jernejsk/sbc-uart-hub/docs/img/render-top.png

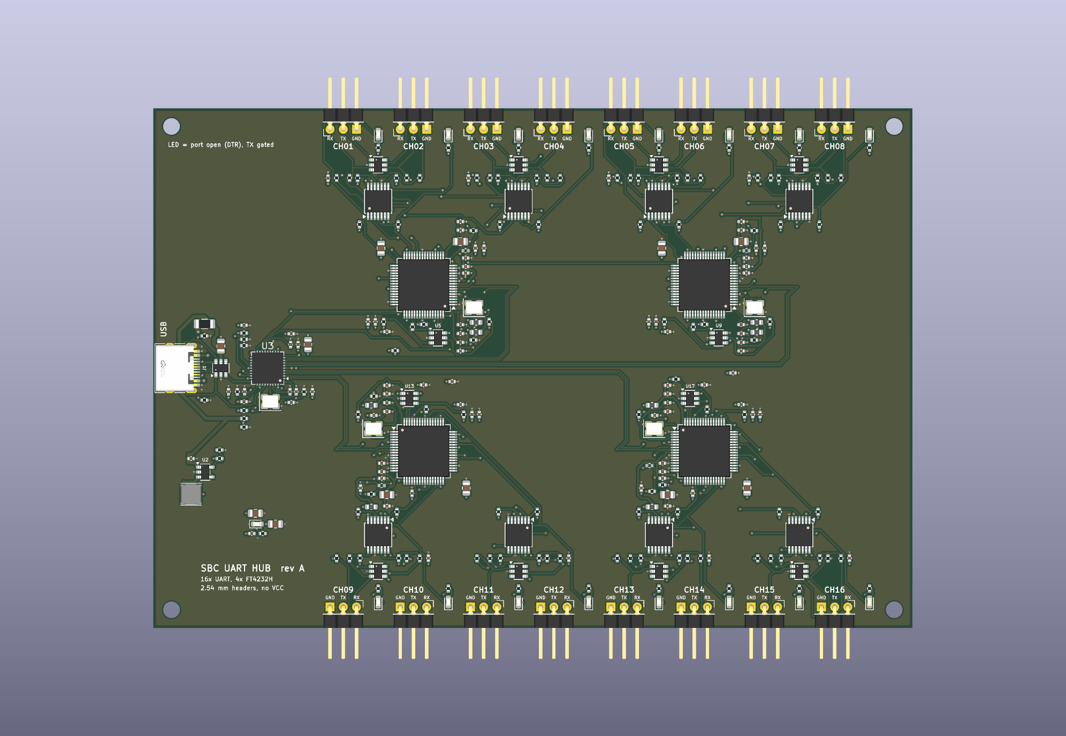
docs/img/render-top.png
