jernejsk/sbc-uart-hub/docs/img/render-iso.png

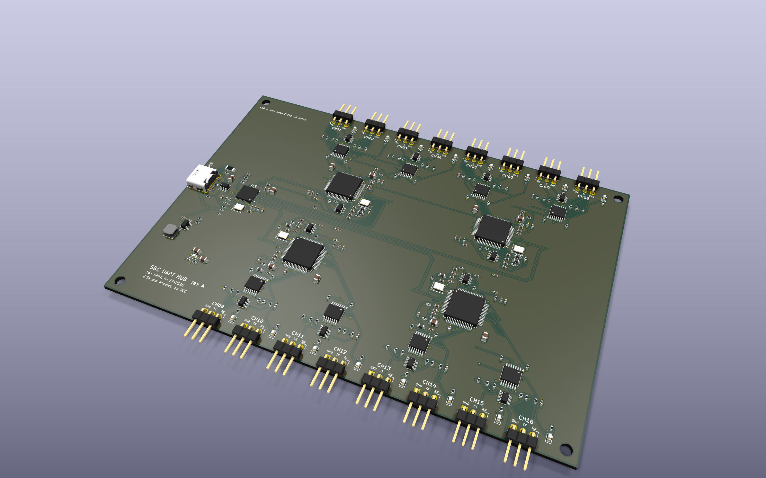
docs/img/render-iso.png
