jernejsk/sbc-uart-hub/docs/img/render-bottom.png

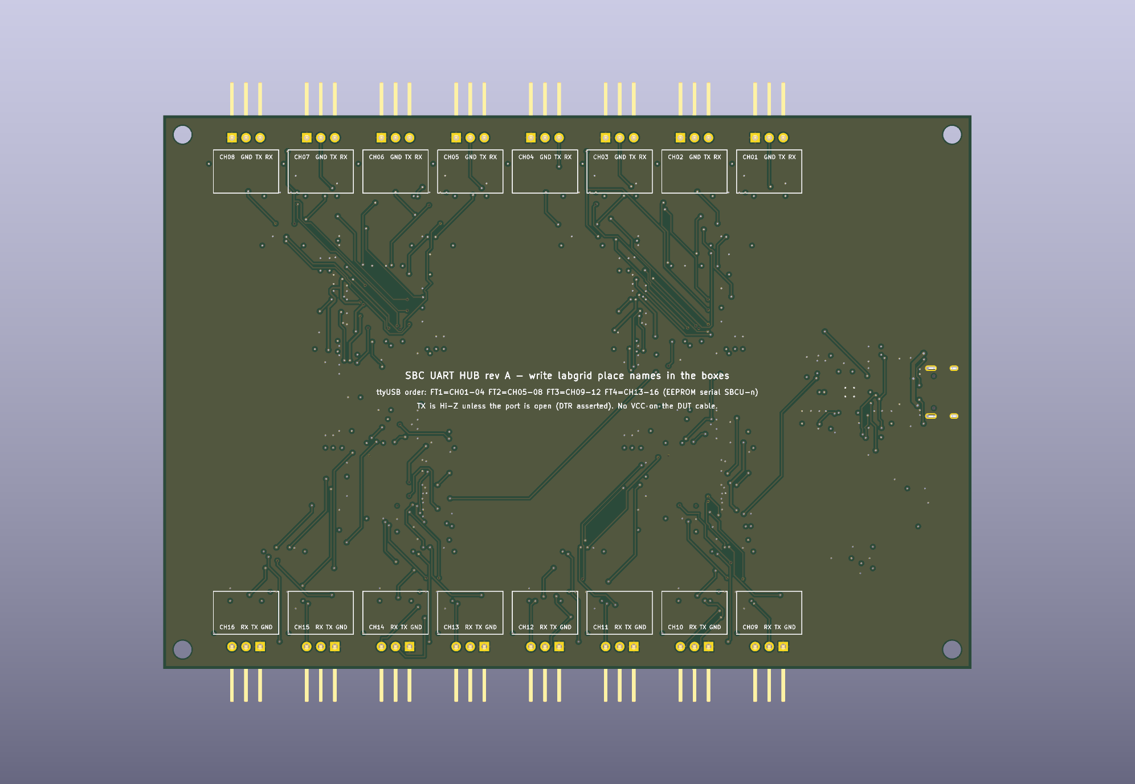
docs/img/render-bottom.png
