jernejsk/sbc-uart-hub/fab/render-bottom.png

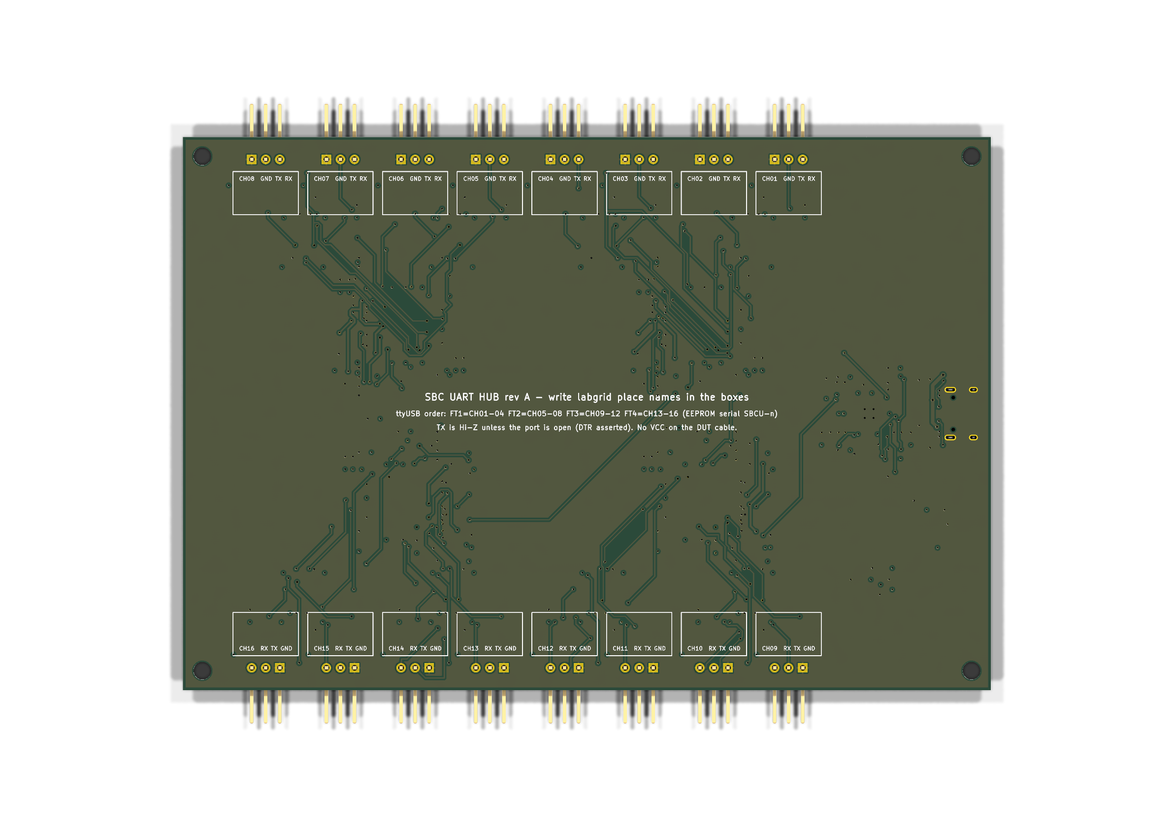
fab/render-bottom.png
