jernejsk/sbc-uart-hub/fab/render-top.png

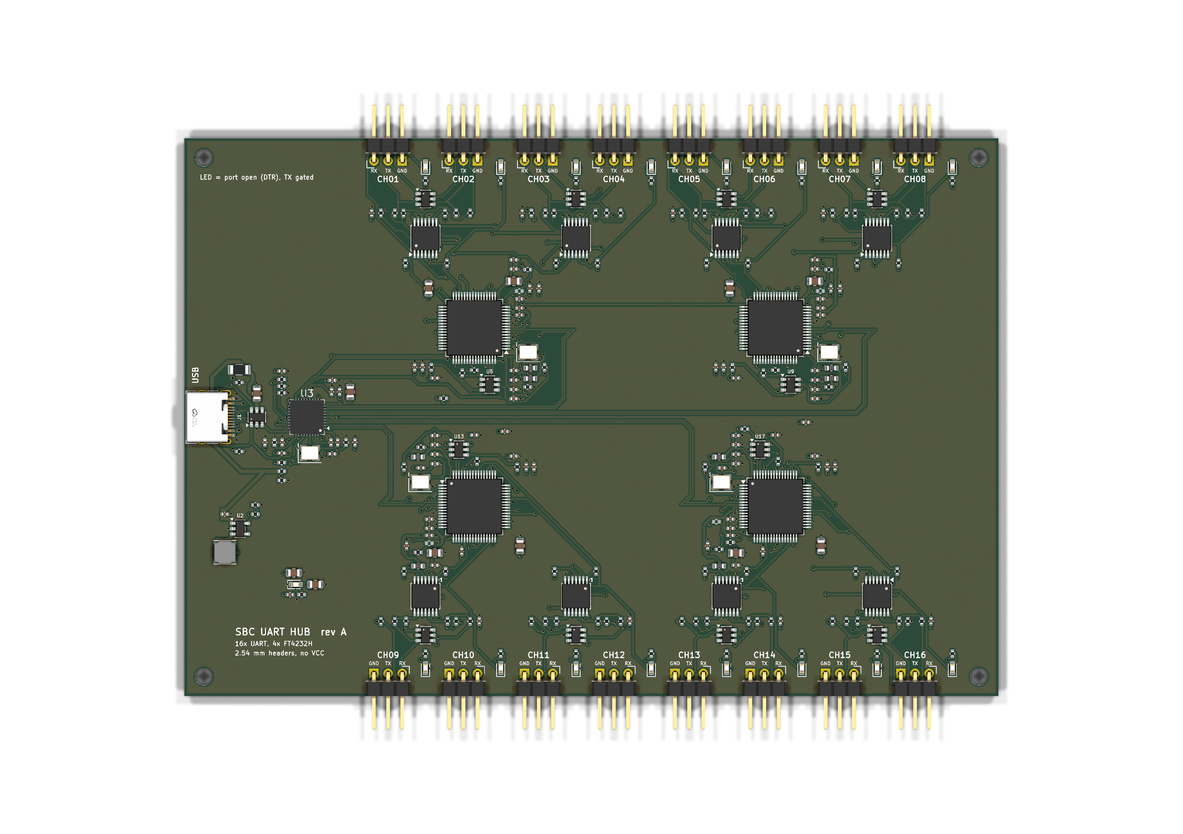
fab/render-top.png
