jernejsk/sbc-uart-hub/fab/bom_jlc.csv

Comment | Designator | Footprint | LCSC Part # | Qty
10u | C1,C3,C4 | C_0805_2012Metric | C15850 | 3
100n | C2,C5,C6,C7,C8,C9,C10,C11,C13,C14,C18,C22,C24,C25,C26,C27,C28,C29,C30,C32,C34,C35,C36,C37,C41,C43,C44,C45,C46,C47,C48,C49,C51,C53,C54,C55,C56,C60,C62,C63,C64,C65,C66,C67,C68,C70,C72,C73,C74,C75,C79,C81,C82,C83,C84,C85,C86,C87,C89,C91,C92,C93 | C_0402_1005Metric | C1525 | 62
4u7 | C12,C21,C23,C40,C42,C59,C61,C78,C80 | C_0805_2012Metric | C1779 | 9
33p | C15,C16 | C_0402_1005Metric | C1562 | 2
1u | C17,C31,C33,C50,C52,C69,C71,C88,C90 | C_0402_1005Metric | C52923 | 9
27p | C19,C20,C38,C39,C57,C58,C76,C77 | C_0402_1005Metric | C1557 | 8
red | D1 | LED_0603_1608Metric | C2286 | 1
ESDA6V1-5SC6 | D2,D5,D8,D11,D14,D17,D20,D23 | SOT-23-6 | C2827672 | 8
green | D3,D4,D6,D7,D9,D10,D12,D13,D15,D16,D18,D19,D21,D22,D24,D25 | LED_0603_1608Metric | C12624 | 16
1.1A | F1 | Fuse_1206_3216Metric | C20801 | 1
600R@100MHz | FB1,FB2,FB3,FB4,FB5,FB6,FB7,FB8 | L_0603_1608Metric | C1002 | 8
USB-C | J1 | USB_C_Receptacle_HRO_TYPE-C-31-M-12 | C165948 | 1
Header 1x3 RA | J101,J102,J103,J104,J105,J106,J107,J108,J109,J110,J111,J112,J113,J114,J115,J116 | PinHeader_1x03_P2.54mm_Horizontal_Edge | C492411 | 16
2u2 | L1 | L_Taiyo-Yuden_NR-40xx | C83423 | 1
5k1 | R1,R2 | R_0402_1005Metric | C25905 | 2
100k | R3,R8,R9,R10,R11,R12,R13,R26,R31,R36,R41,R52,R57,R62,R67,R78,R83,R88,R93,R104,R109,R114,R119 | R_0402_1005Metric | C25741 | 23
22k | R4 | R_0402_1005Metric | C25768 | 1
1k | R5,R28,R33,R38,R43,R54,R59,R64,R69,R80,R85,R90,R95,R106,R111,R116,R121 | R_0402_1005Metric | C11702 | 17
12k 1% | R6,R22,R48,R74,R100 | R_0402_1005Metric | C25752 | 5
10k | R7,R18,R19,R20,R23,R27,R32,R37,R42,R44,R45,R46,R49,R53,R58,R63,R68,R70,R71,R72,R75,R79,R84,R89,R94,R96,R97,R98,R101,R105,R110,R115,R120 | R_0402_1005Metric | C25744 | 33
2k2 | R21,R47,R73,R99 | R_0402_1005Metric | C25879 | 4
220R | R24,R25,R29,R30,R34,R35,R39,R40,R50,R51,R55,R56,R60,R61,R65,R66,R76,R77,R81,R82,R86,R87,R91,R92,R102,R103,R107,R108,R112,R113,R117,R118 | R_0402_1005Metric | C25091 | 32
USBLC6-2SC6 | U1 | SOT-23-6 | C7519 | 1
TLV62569DBV | U2 | SOT-23-5 | C141836 | 1
USB2514B | U3 | QFN-36-1EP_6x6mm_P0.5mm_EP3.7x3.7mm | C16251 | 1
FT4232HL | U4,U8,U12,U16 | LQFP-64_10x10mm_P0.5mm | C56742 | 4
93LC56B | U5,U9,U13,U17 | SOT-23-6 | C190271 | 4
74LVC125APW | U6,U7,U10,U11,U14,U15,U18,U19 | TSSOP-14_4.4x5mm_P0.65mm | C6059 | 8
24MHz | Y1 | Crystal_SMD_3225-4Pin_3.2x2.5mm | C15643 | 1
12MHz | Y2,Y3,Y4,Y5 | Crystal_SMD_3225-4Pin_3.2x2.5mm | C9002 | 4
