jernejsk/sbc-uart-hub/fab/sbc-uart-hub-schematic.pdf

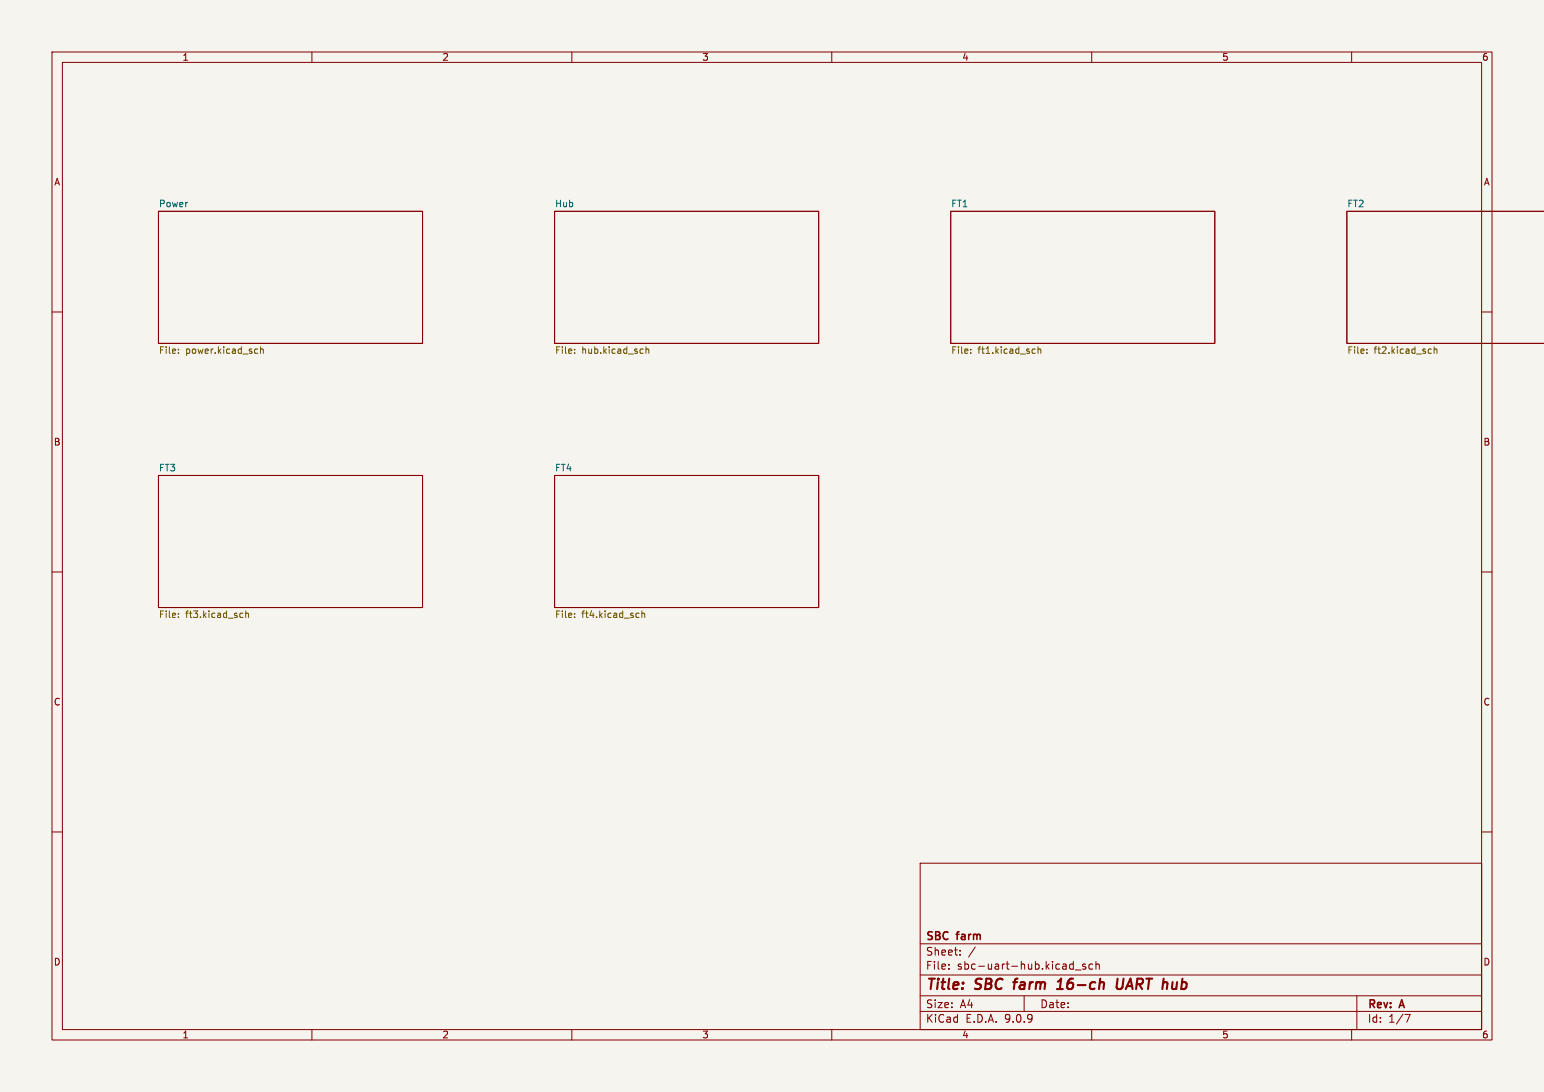
[picture p6: page 1]

File: sbc-uart-hub.kicad_sch Sheet: / SBC farm

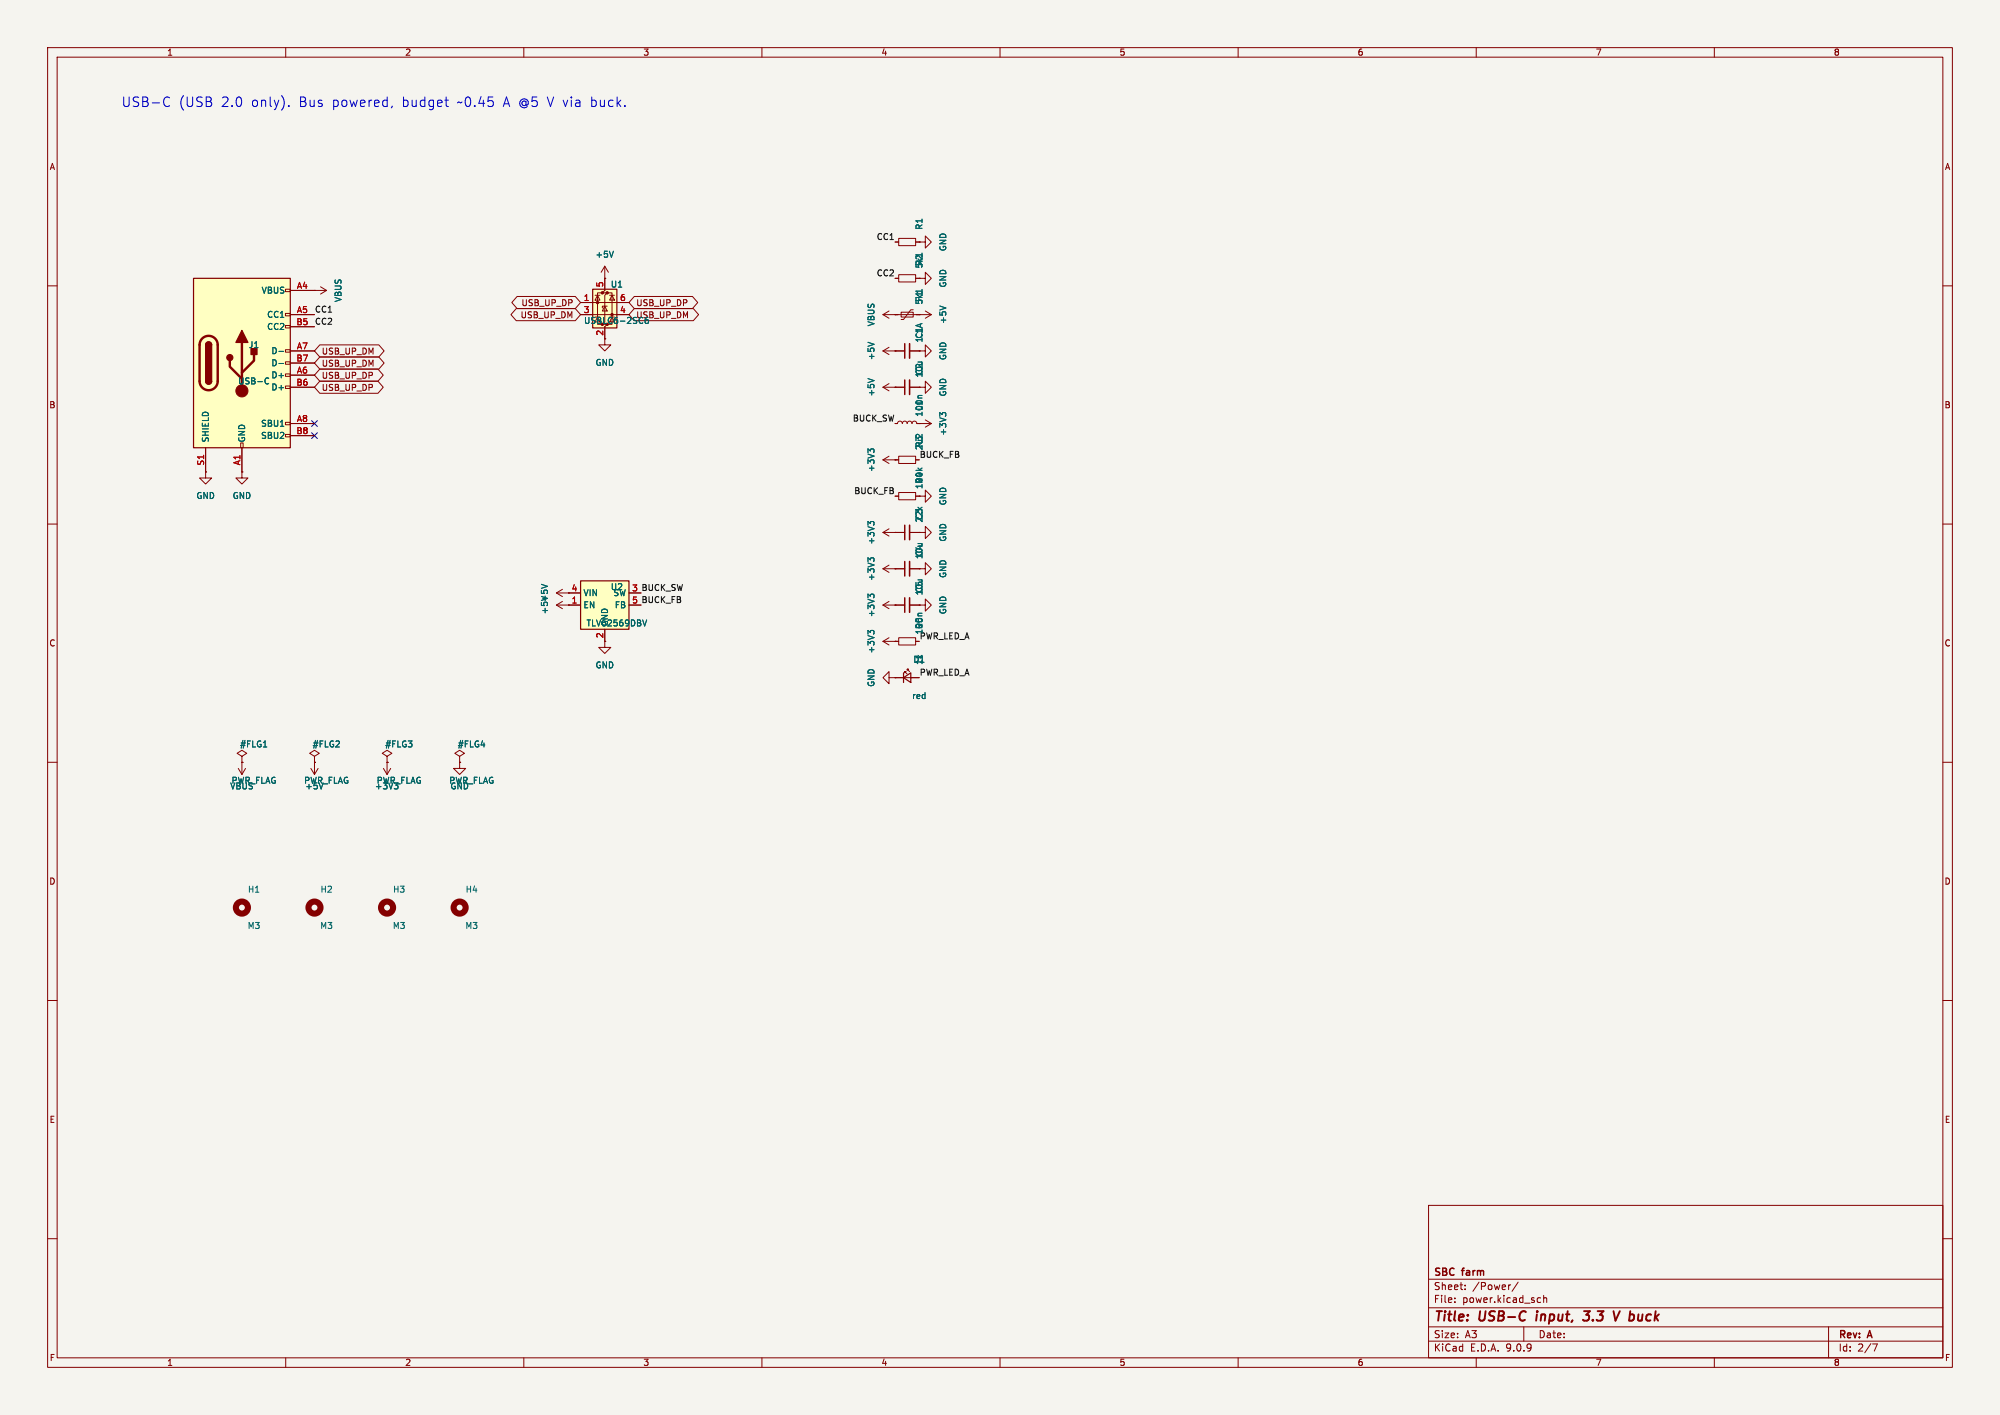
[picture p7: page 2]

Id: 2/7 Title: USB-C input, 3.3 V buck

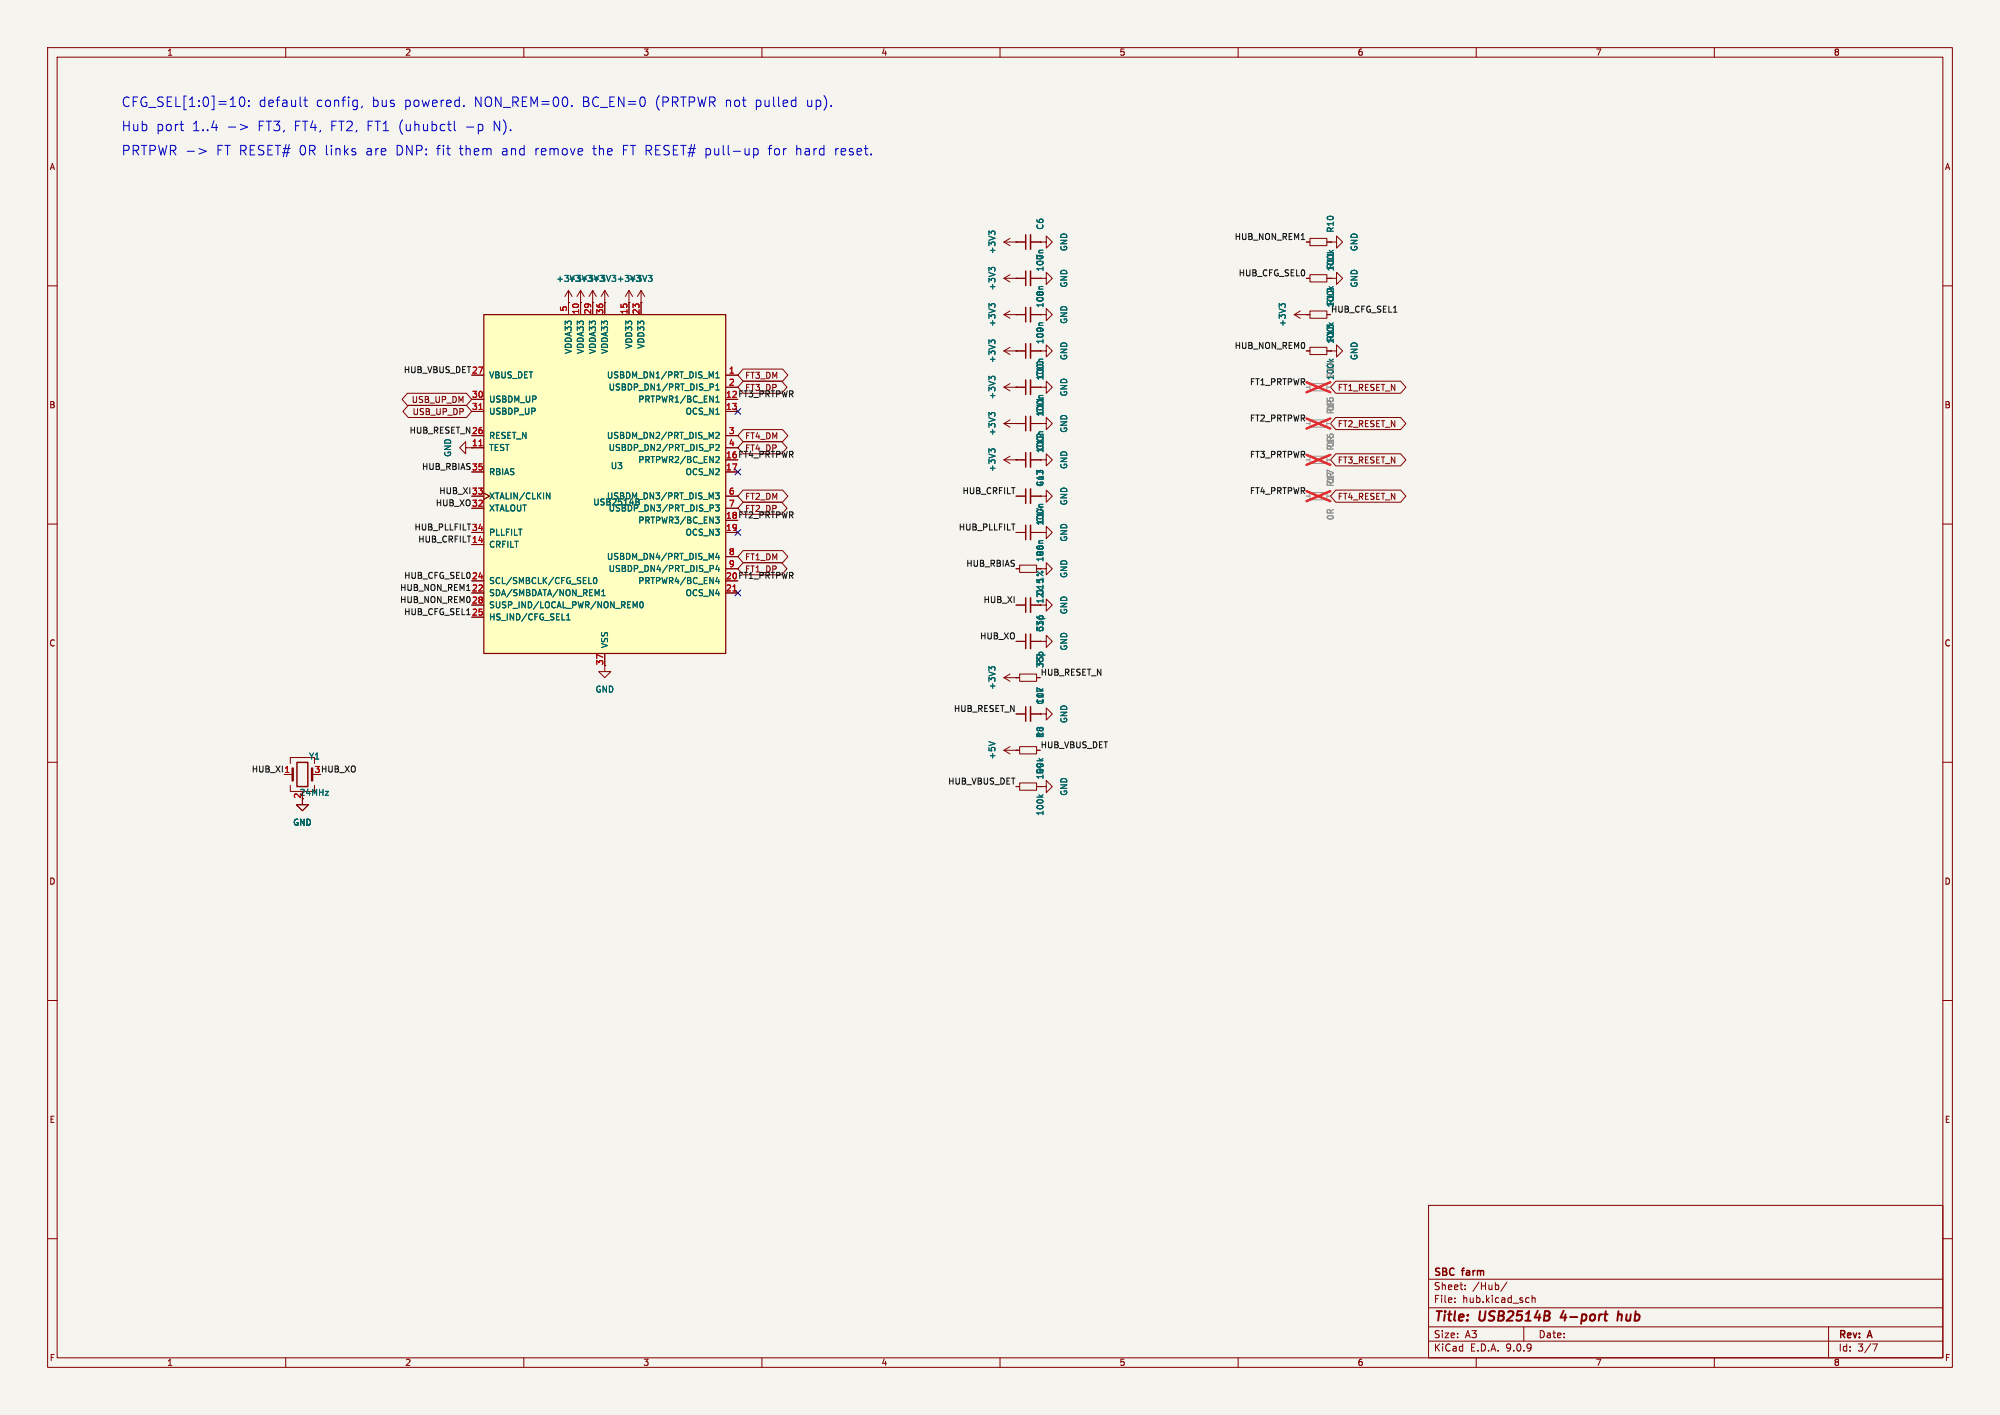
[picture p8: page 3]

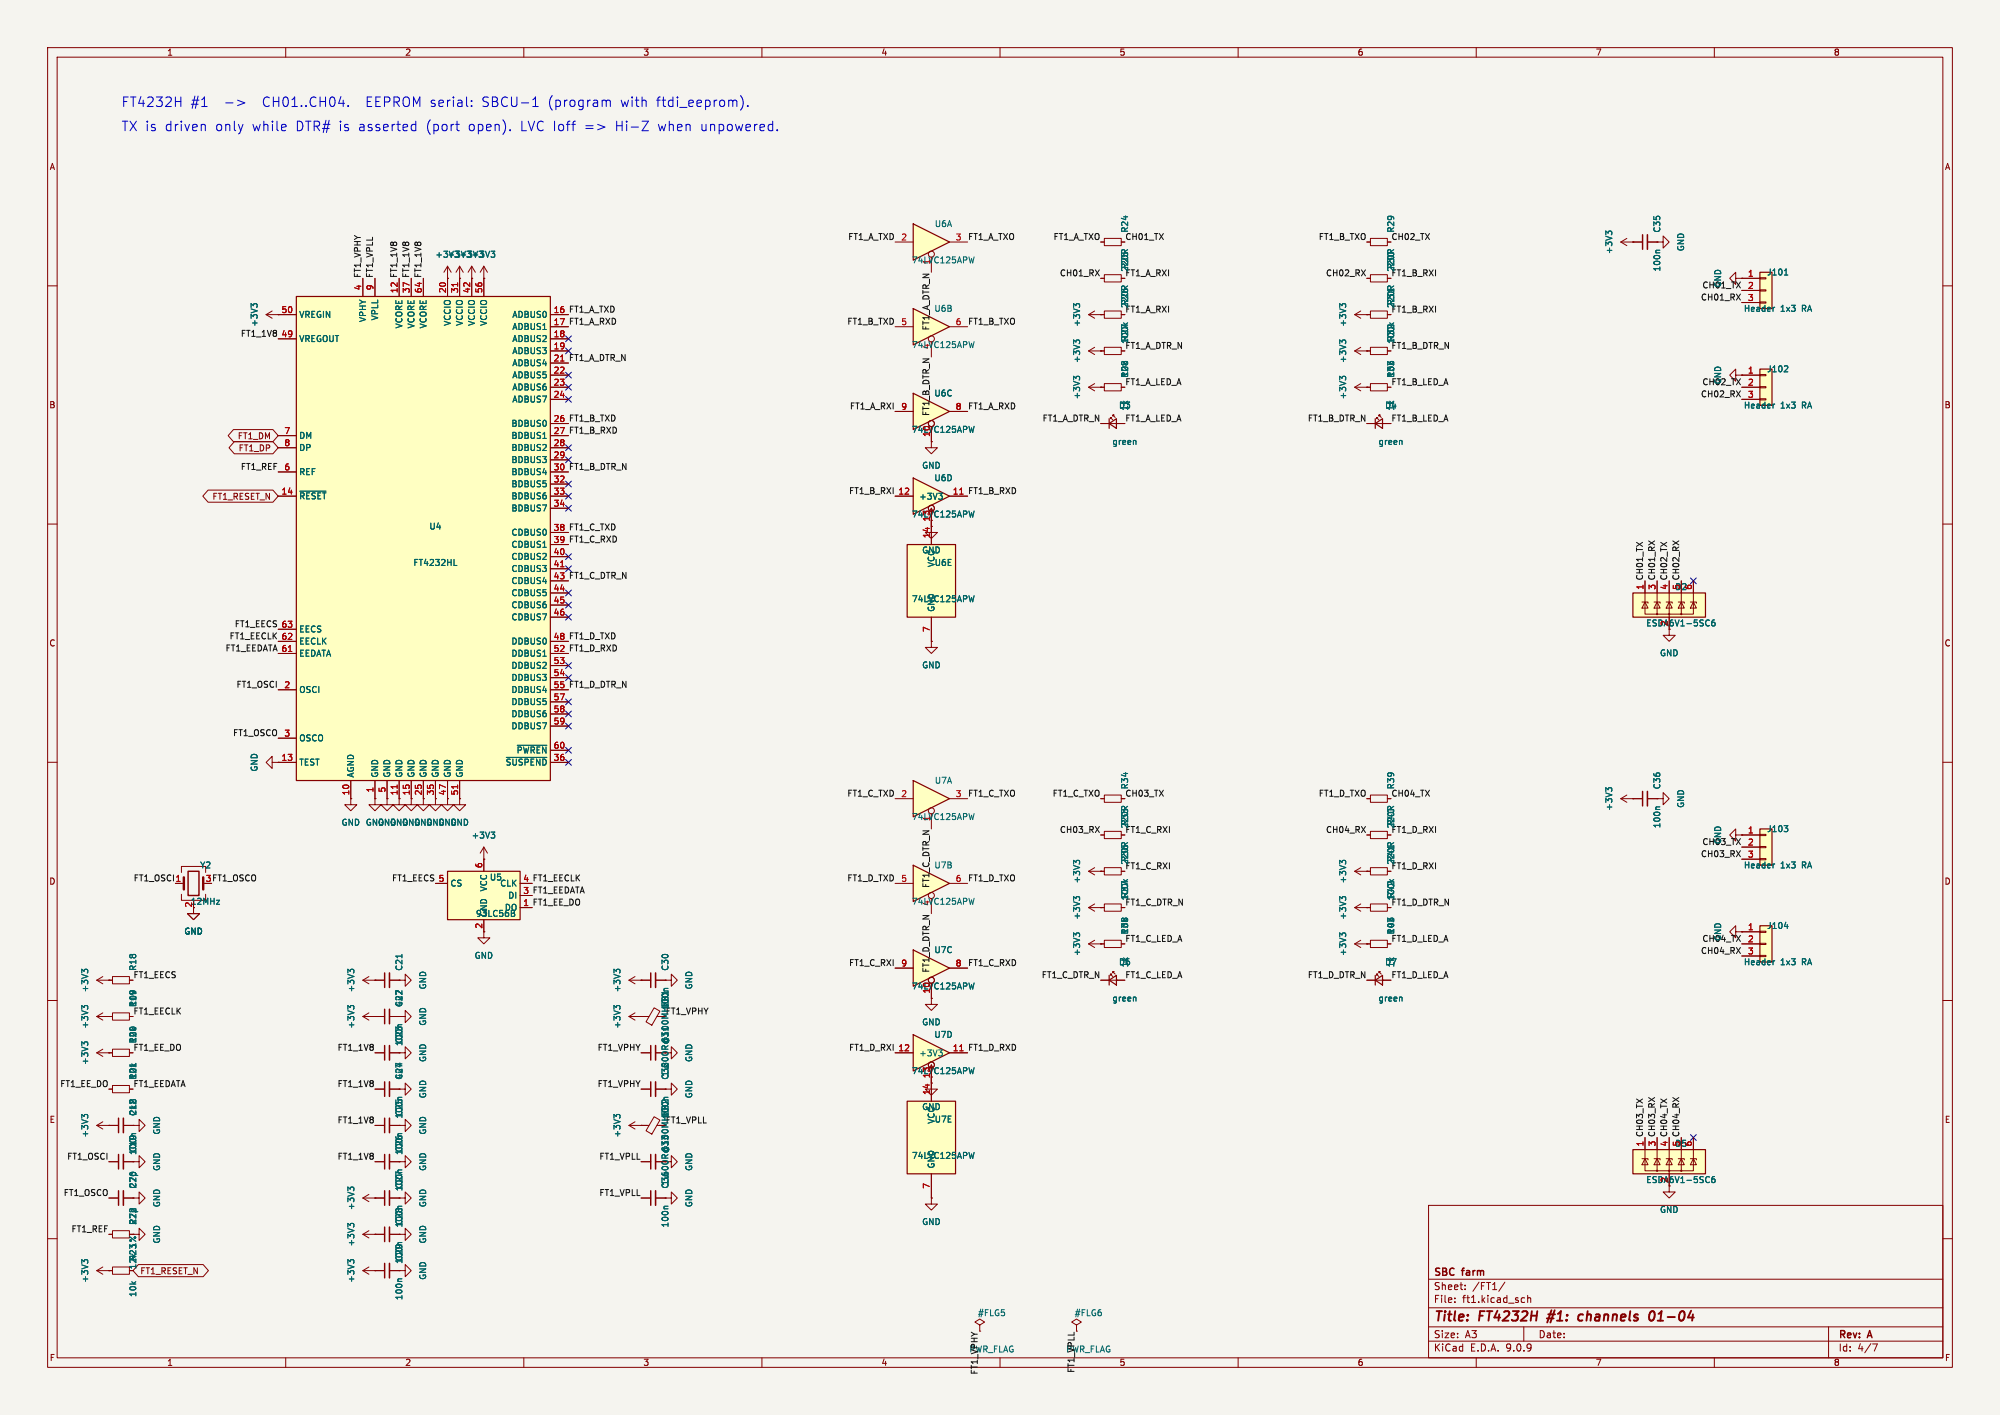
[picture p9: page 4]

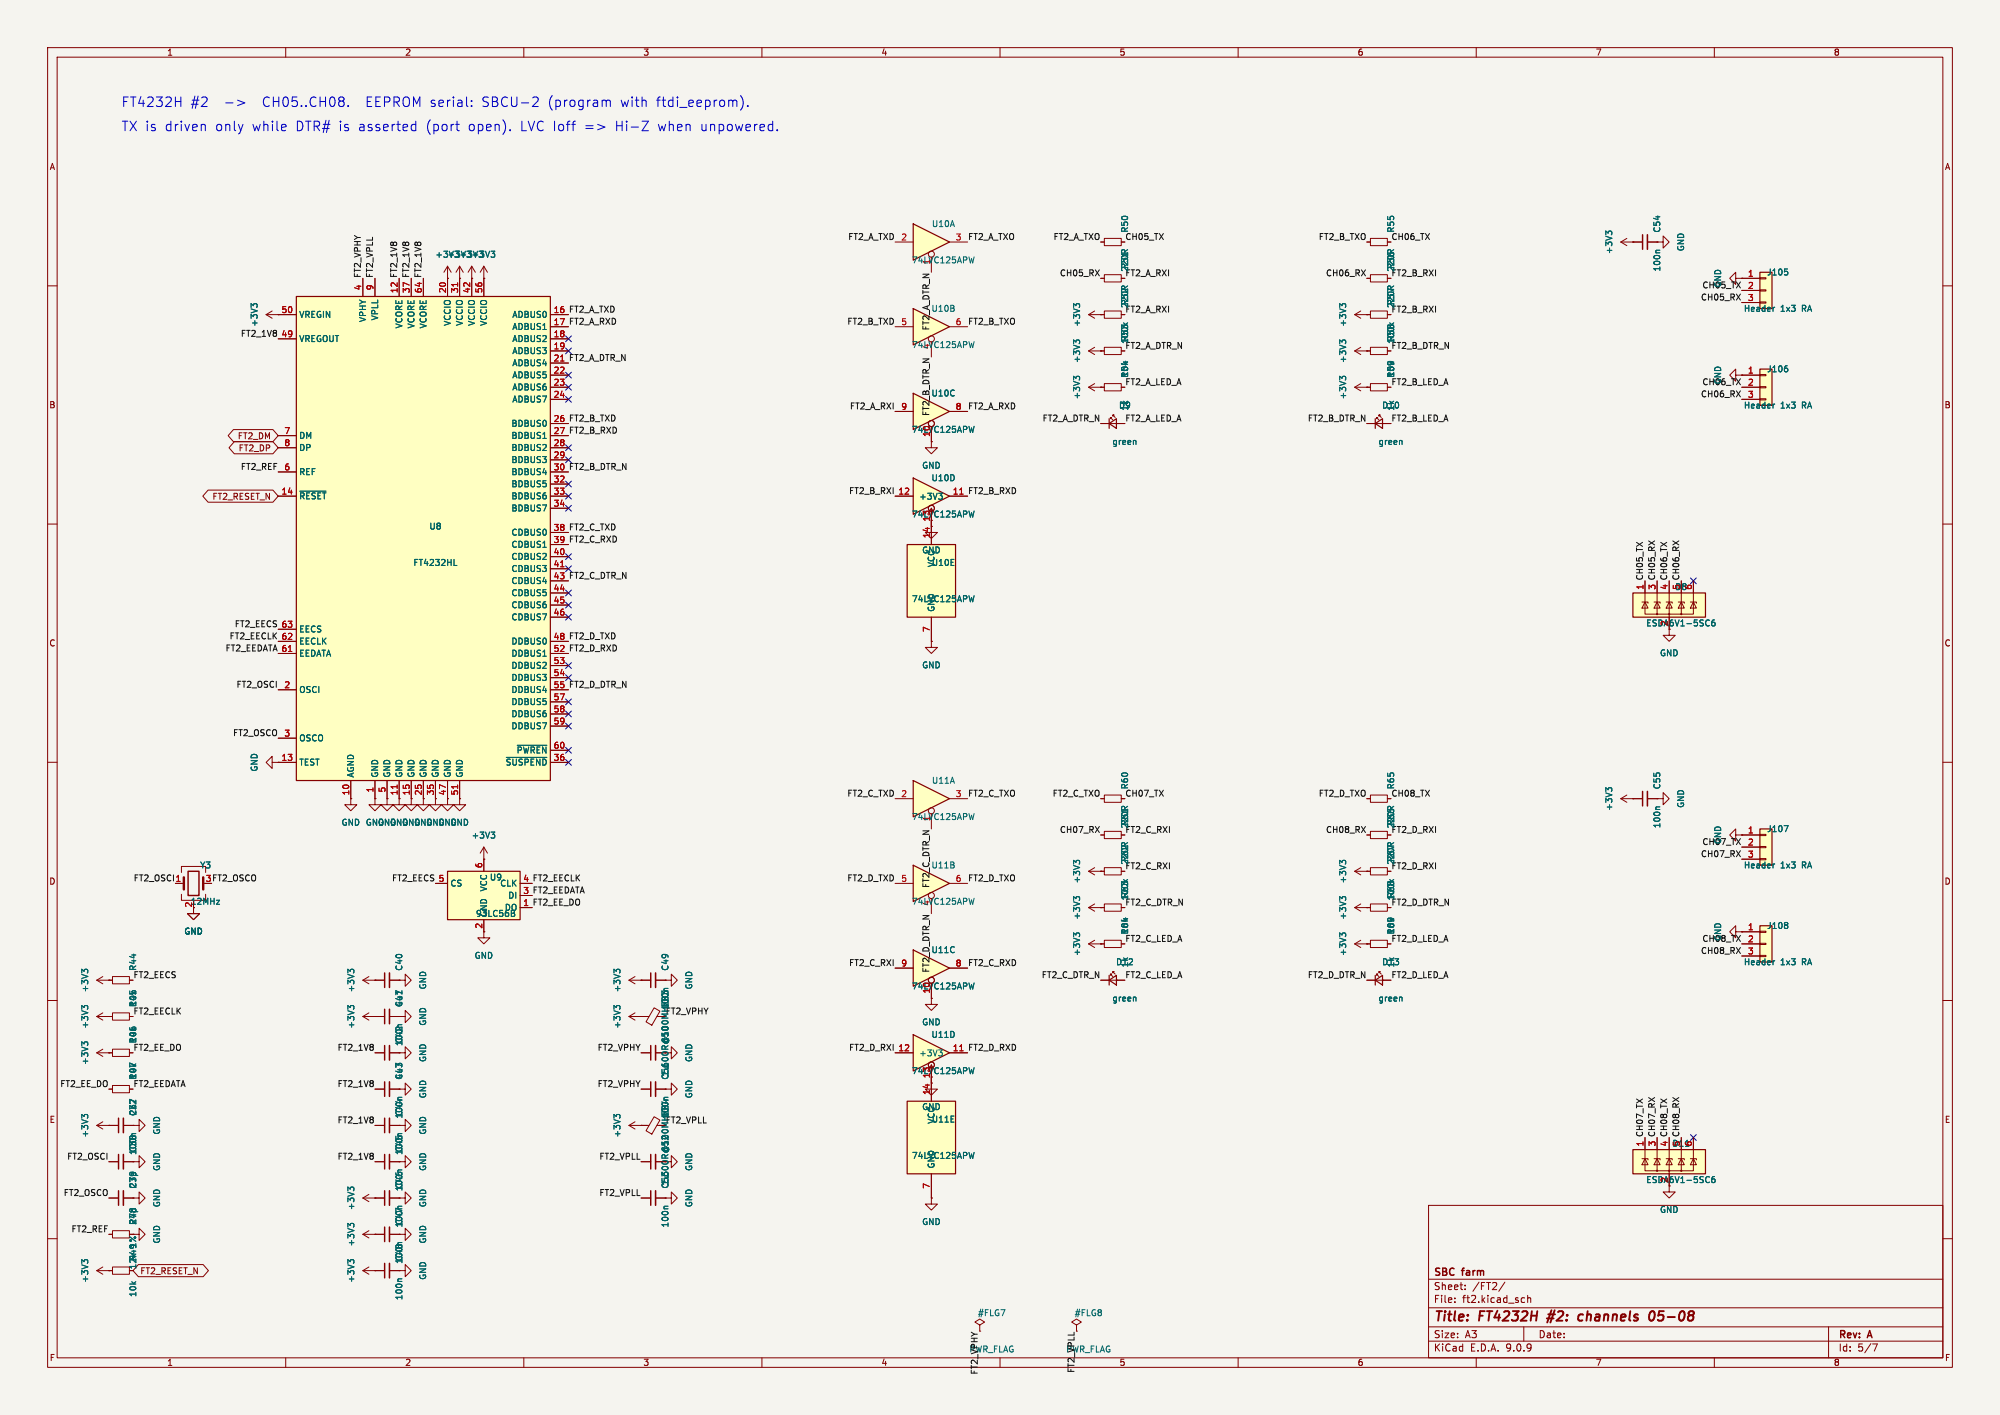
[picture p10: page 5]

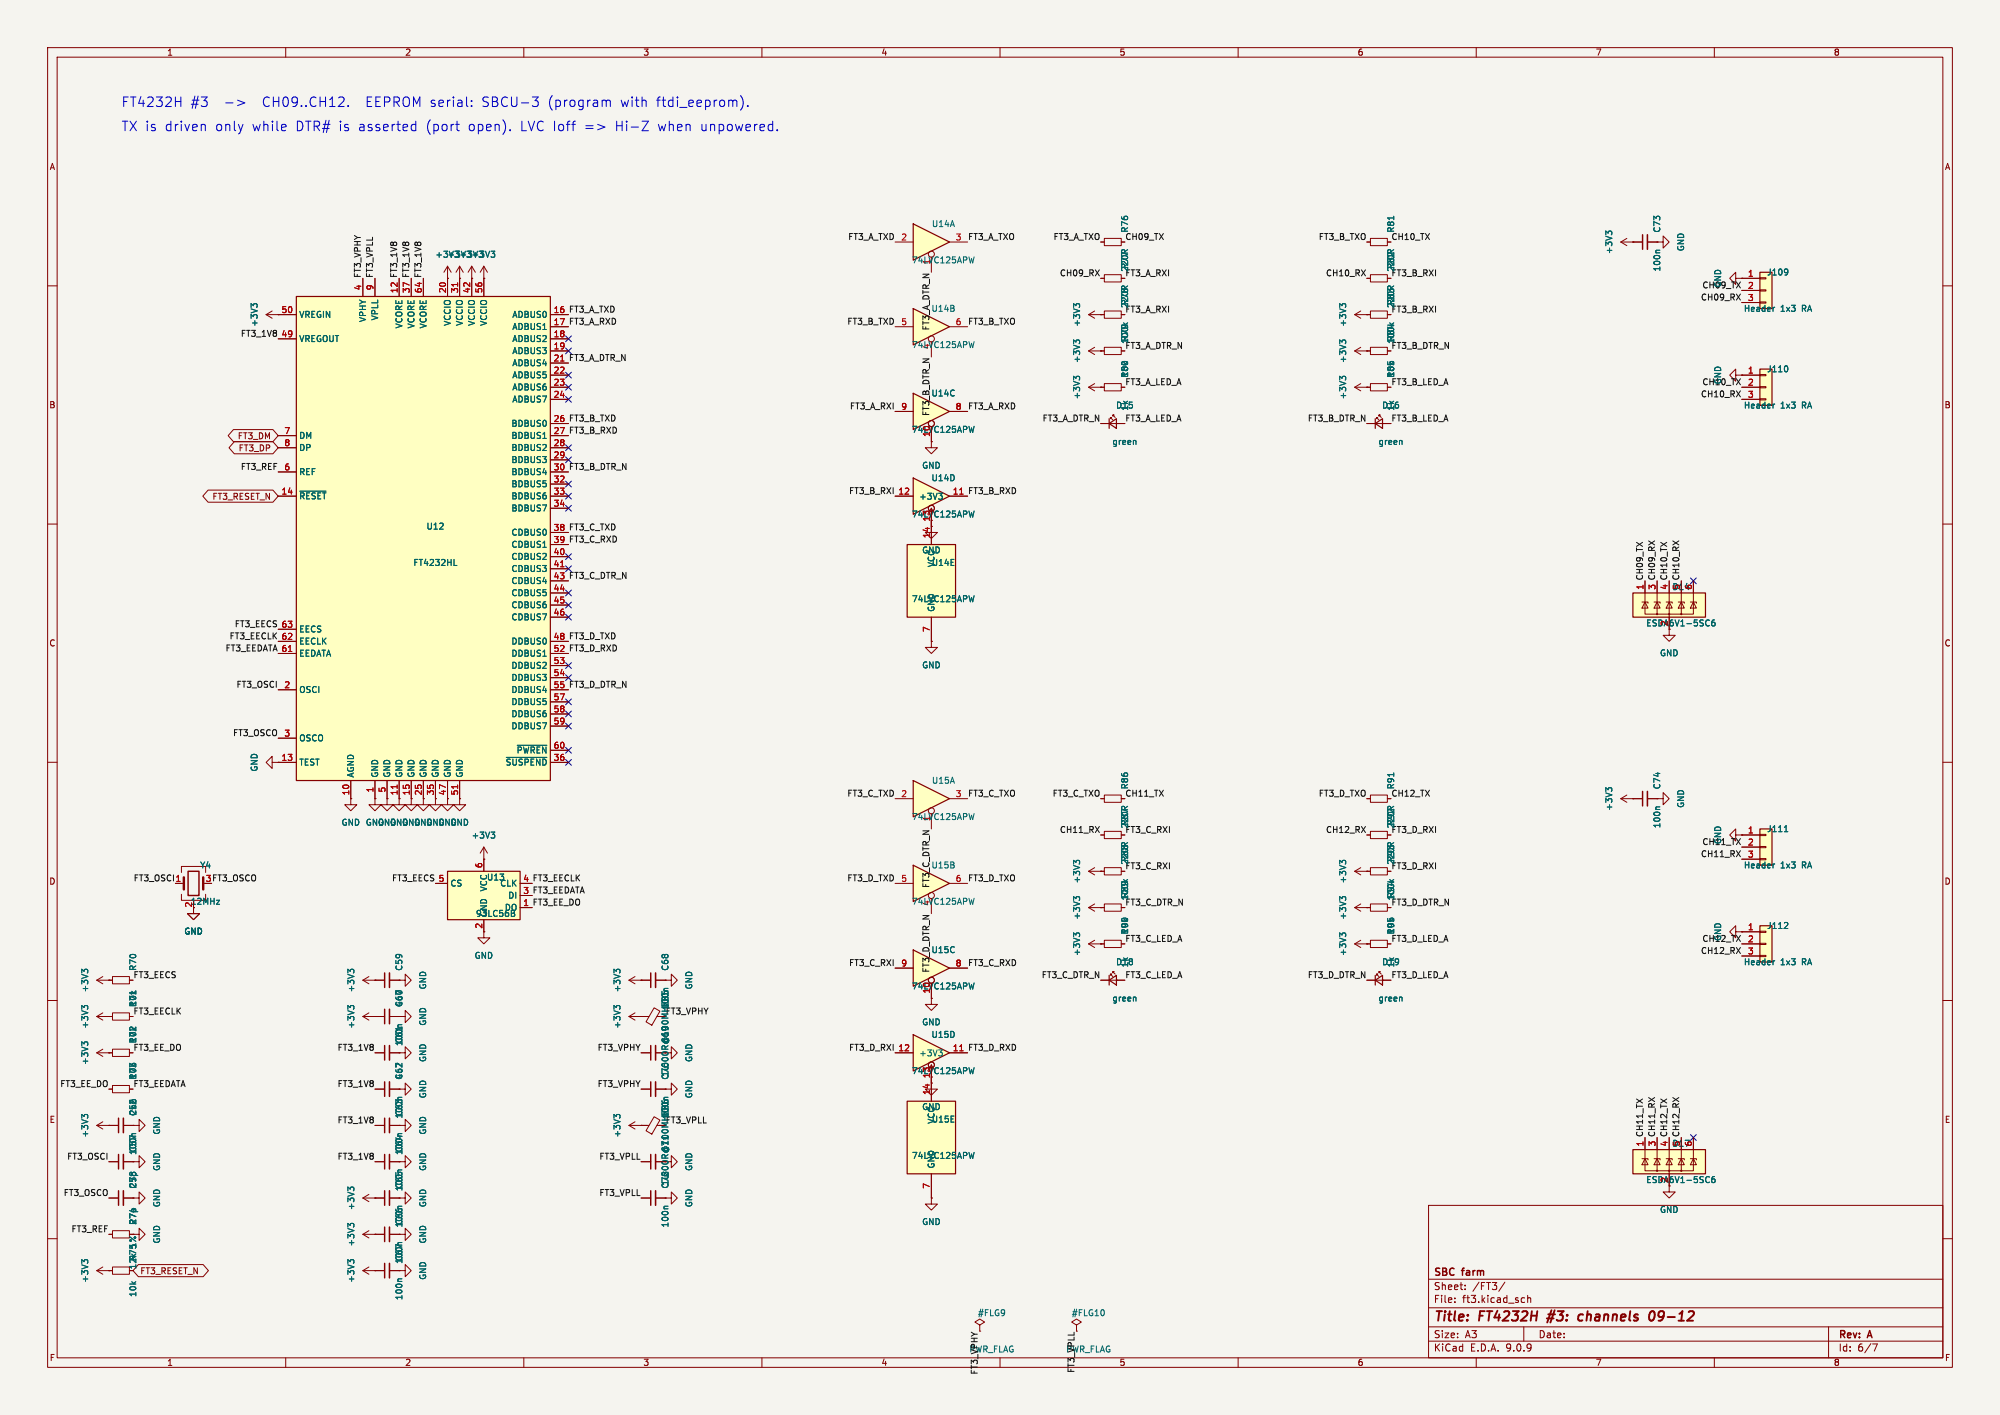
[picture p11: page 6]

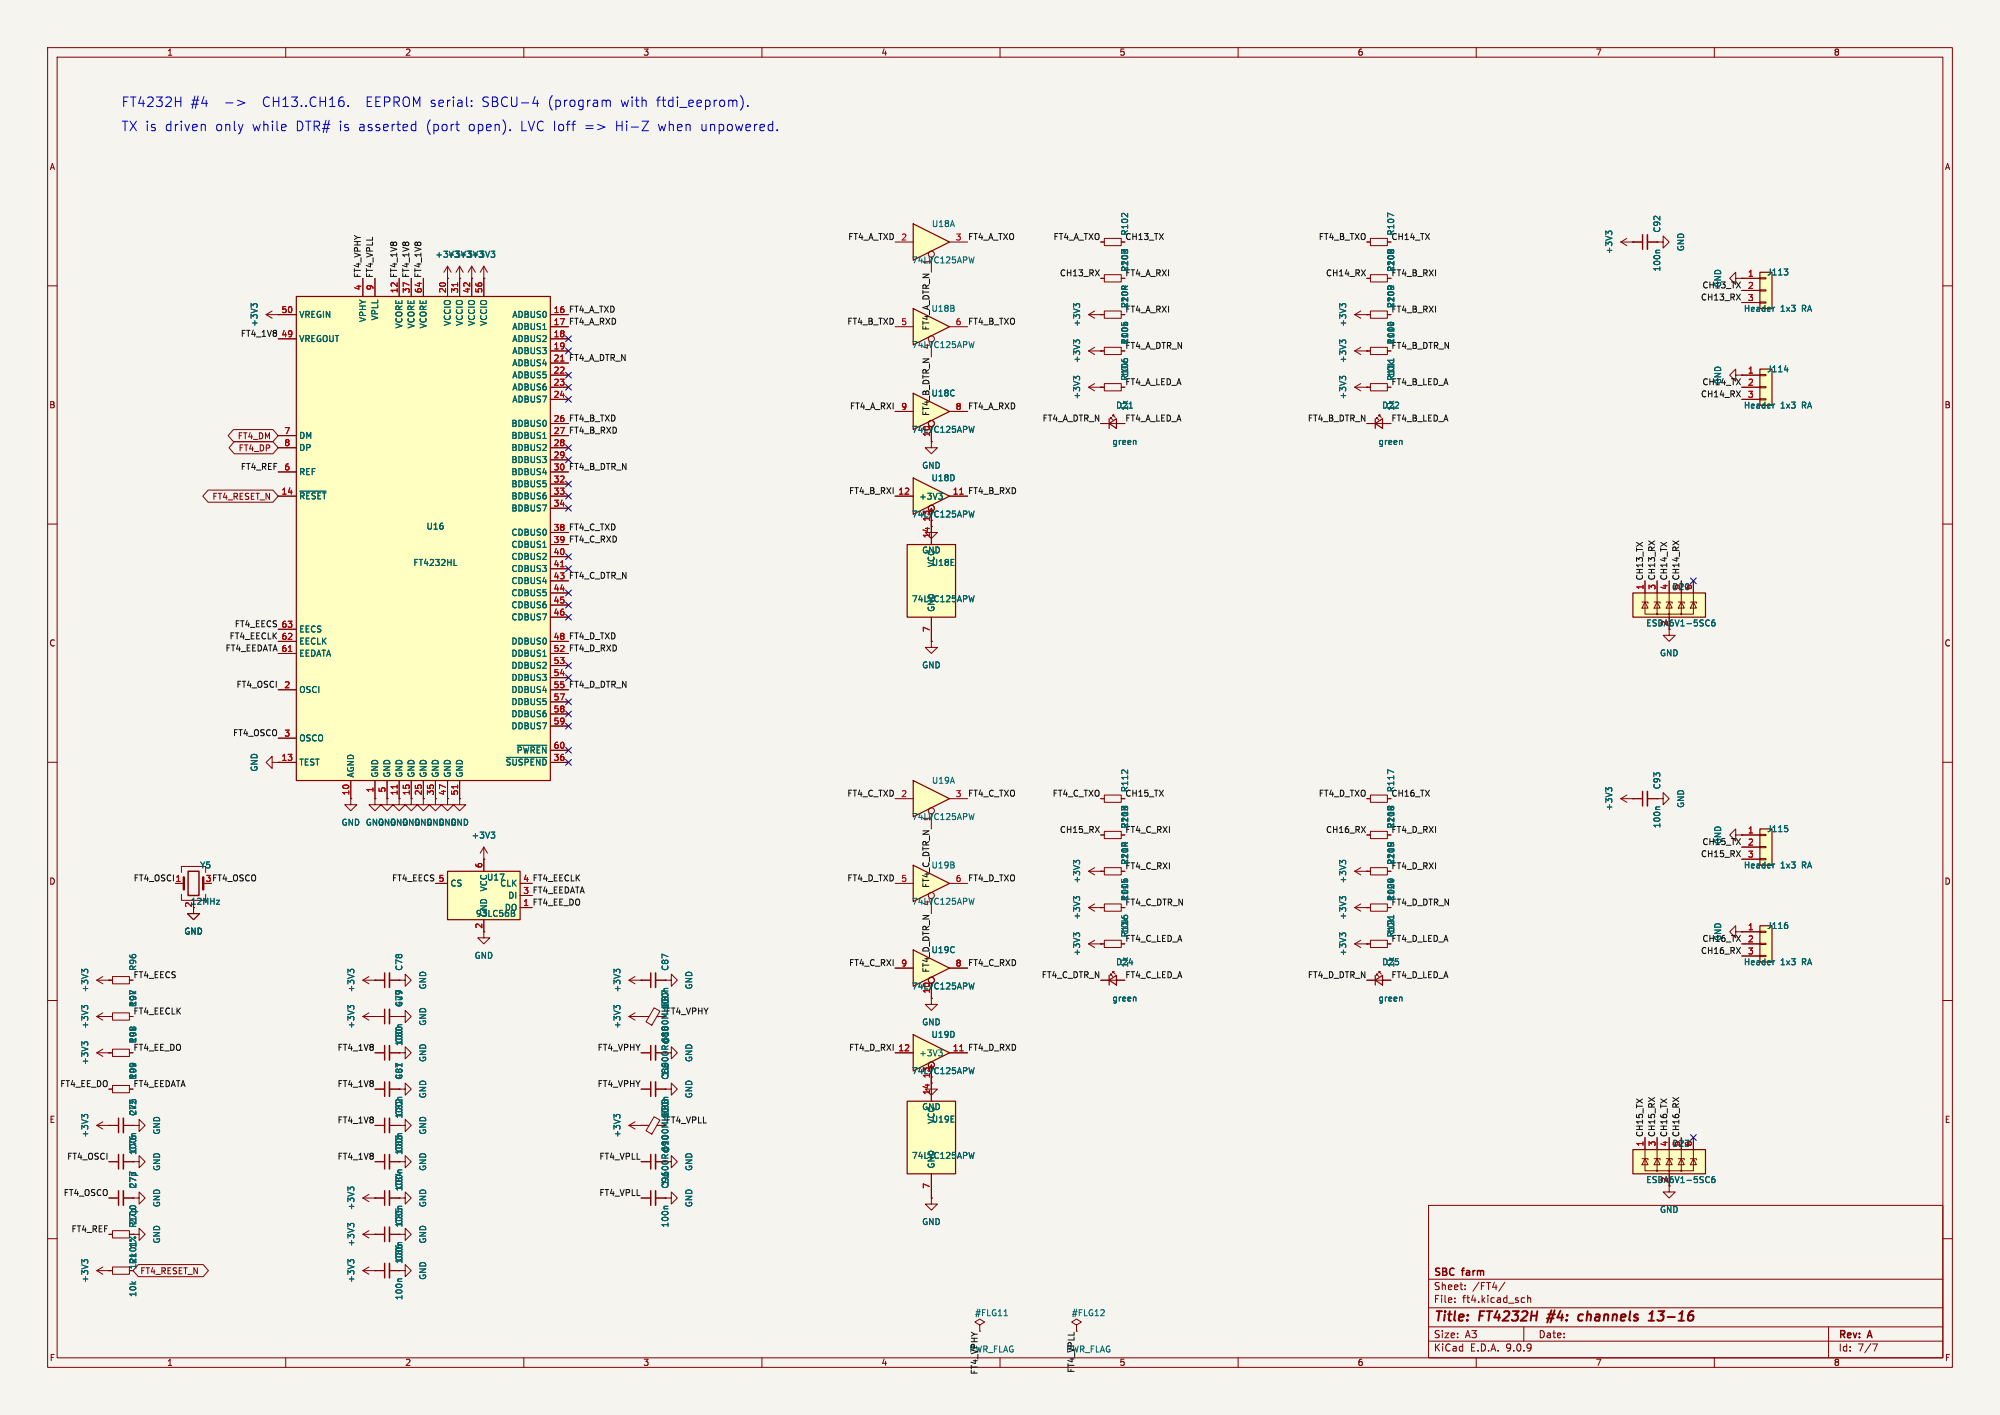
[picture p12: page 7]

FT4_B_RXD TX is driven only while DTR# is asserted (port open). LVC Ioff => Hi-Z when unpowered.
