jernejsk/sbc-uart-hub/hw/sbc-uart-hub.kicad_pcb

## KiCad design hw/sbc-uart-hub.kicad_pcb (2026-11-08)

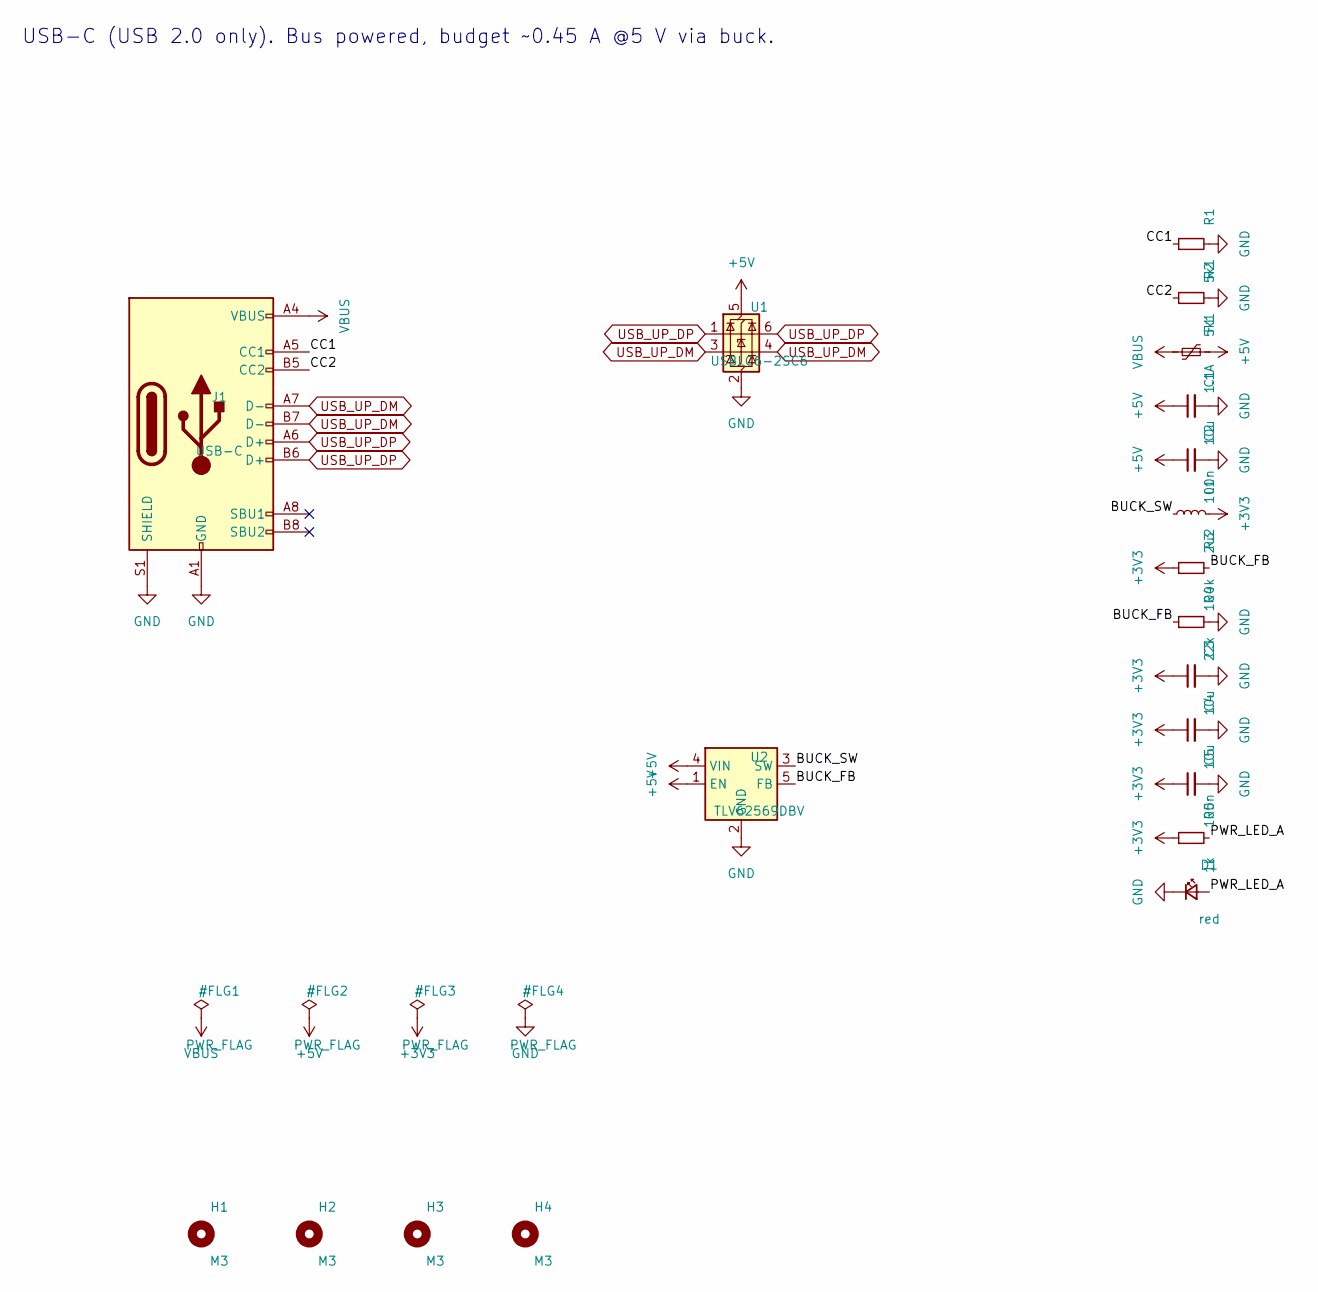
[picture p13: schematic power.kicad_sch, USB-C input, 3.3 V buck]

Parts:
C1, C3, C4: 10u; C_0805_2012Metric; MPN CL21A106KAYNNNE; LCSC C15850
C2, C5: 100n; C_0402_1005Metric; MPN CL05B104KO5NNNC; LCSC C1525
D1: red; LED_0603_1608Metric; MPN KT-0603R; LCSC C2286
F1: 1.1A; Fuse_1206_3216Metric; MPN SMD1206P110TF; LCSC C20801
H1, H2, H3, H4: M3; MountingHole_3.2mm_M3
J1: USB-C; USB_C_Receptacle_HRO_TYPE-C-31-M-12; MPN TYPE-C-31-M-12; LCSC C165948
L1: 2u2; L_Taiyo-Yuden_NR-40xx; MPN SWPA4020S2R2MT; LCSC C83423
R1, R2: 5k1; R_0402_1005Metric; MPN 0402WGF5101TCE; LCSC C25905
R3: 100k; R_0402_1005Metric; MPN 0402WGF1003TCE; LCSC C25741
R4: 22k; R_0402_1005Metric; MPN 0402WGF2202TCE; LCSC C25768
R5: 1k; R_0402_1005Metric; MPN 0402WGF1001TCE; LCSC C11702
U1: USBLC6-2SC6; SOT-23-6; MPN USBLC6-2SC6; LCSC C7519
U2: TLV62569DBV; SOT-23-5; MPN TLV62569DBVR; LCSC C141836

Connections:
+3V3: C3.1, C4.1, C5.1, L1.2, R3.1, R5.1; also elsewhere on the board
+5V: C1.1, C2.1, F1.2, U1.5 (VBUS), U2.1 (EN), U2.4 (VIN); also elsewhere on the board
/Power/BUCK_FB: R3.2, R4.1, U2.5 (FB)
/Power/BUCK_SW: L1.1, U2.3 (SW)
/Power/CC1: J1.A5 (CC1), R1.1
/Power/CC2: J1.B5 (CC2), R2.1
/Power/PWR_LED_A: D1.2 (A), R5.2
GND: C1.2, C2.2, C3.2, C4.2, C5.2, D1.1 (K), J1.A1 (GND), J1.A12 (GND), J1.B1 (GND), J1.B12 (GND), J1.S1 (SHIELD), R1.2, R2.2, R4.2, U1.2 (GND), U2.2 (GND); also elsewhere on the board
USB_UP_DM: J1.A7 (D-), J1.B7 (D-), U1.3 (I/O2), U1.4 (I/O2); also elsewhere on the board
USB_UP_DP: J1.A6 (D+), J1.B6 (D+), U1.1 (I/O1), U1.6 (I/O1); also elsewhere on the board
VBUS: F1.1, J1.A4 (VBUS), J1.A9 (VBUS), J1.B4 (VBUS), J1.B9 (VBUS)

Notes on the sheet:
USB-C (USB 2.0 only). Bus powered, budget ~0.45 A @5 V via buck.

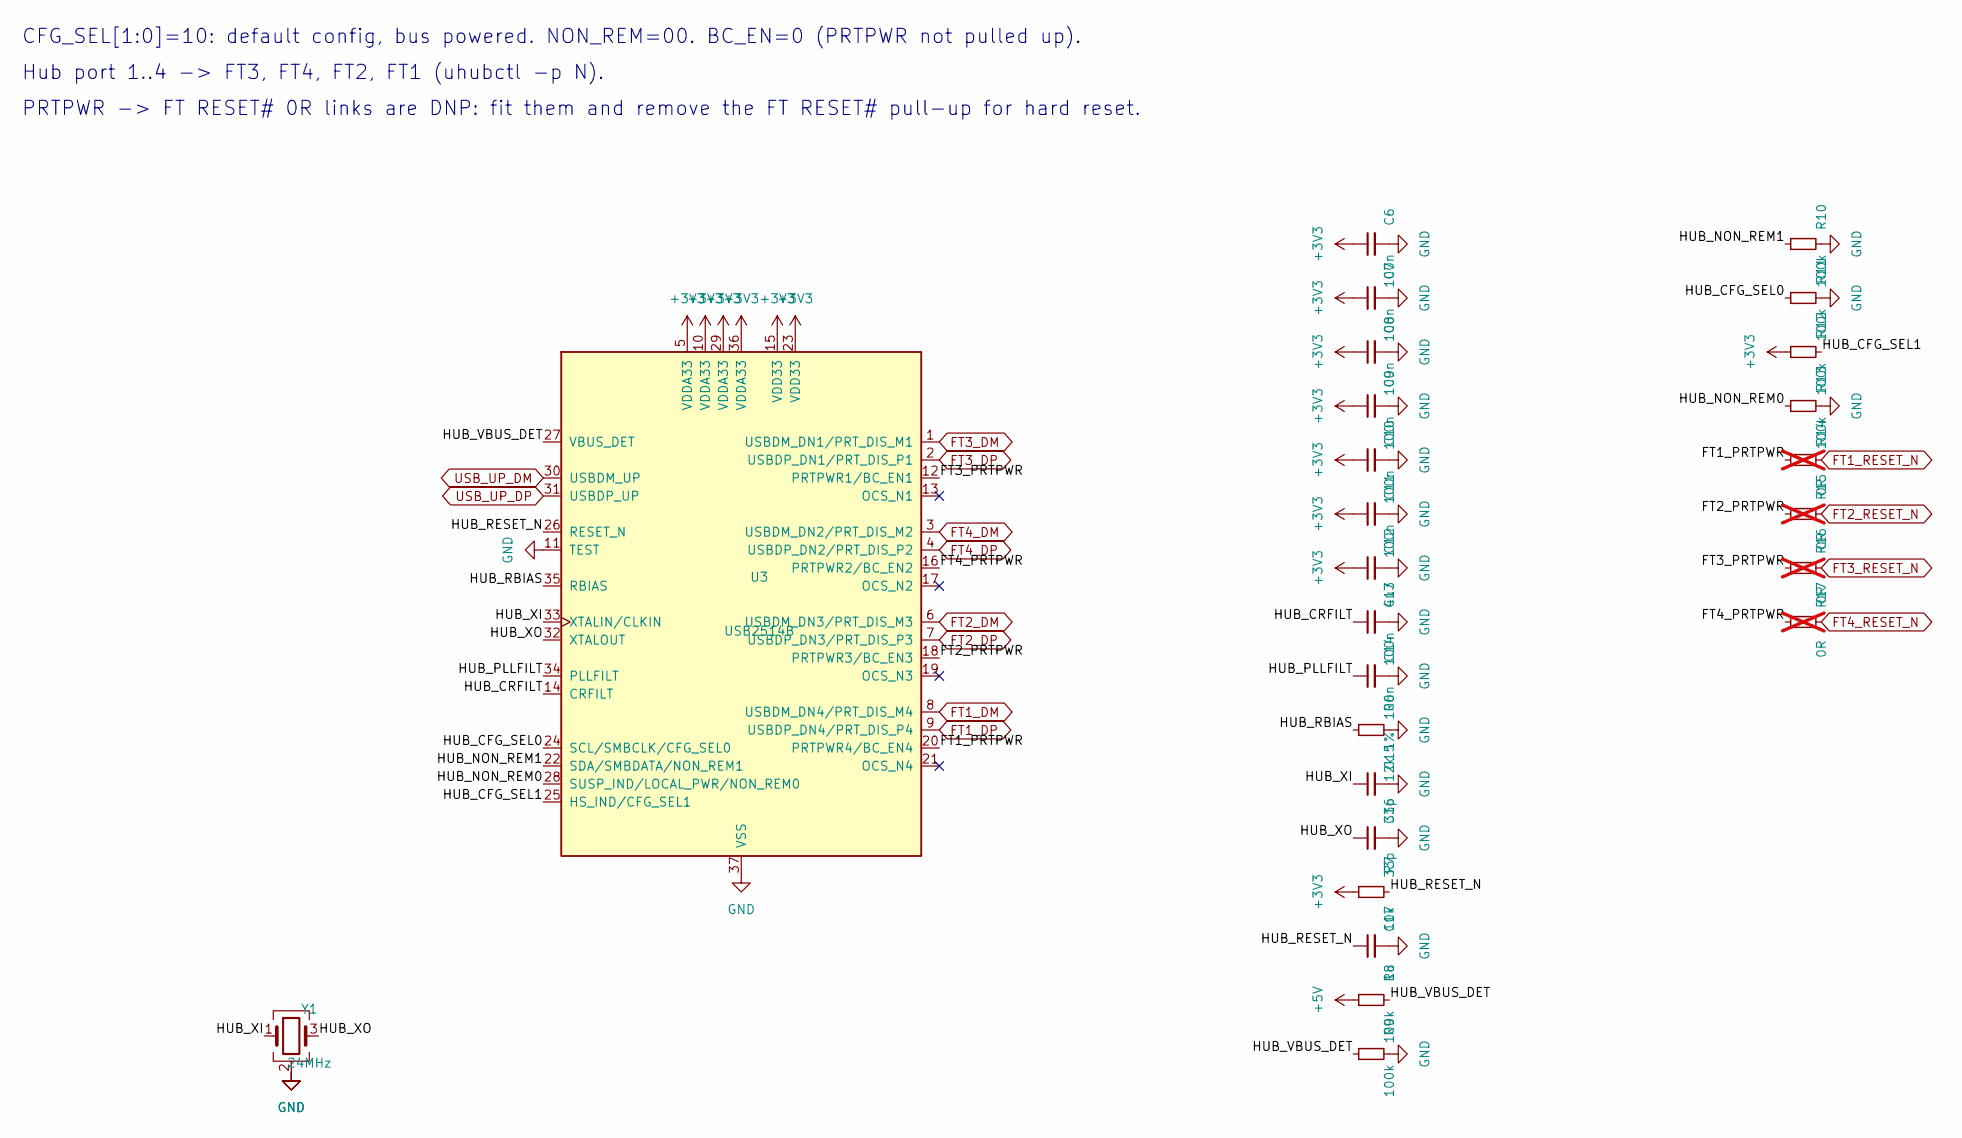
[picture p14: schematic hub.kicad_sch, USB2514B 4-port hub]

Parts:
C6, C7, C8, C9, C10, C11, C13, C14: 100n; C_0402_1005Metric; MPN CL05B104KO5NNNC; LCSC C1525
C12: 4u7; C_0805_2012Metric; MPN CL21A475KAQNNNE; LCSC C1779
C15, C16: 33p; C_0402_1005Metric; MPN 0402CG330J500NT; LCSC C1562
C17: 1u; C_0402_1005Metric; MPN CL05A105KA5NQNC; LCSC C52923
R6: 12k 1%; R_0402_1005Metric; MPN 0402WGF1202TCE; LCSC C25752
R7: 10k; R_0402_1005Metric; MPN 0402WGF1002TCE; LCSC C25744
R8, R9, R10, R11, R12, R13: 100k; R_0402_1005Metric; MPN 0402WGF1003TCE; LCSC C25741
R14, R15, R16, R17: 0R; R_0402_1005Metric; MPN 0402WGF0000TCE; LCSC C17168; not fitted
U3: USB2514B; QFN-36-1EP_6x6mm_P0.5mm_EP3.7x3.7mm; MPN USB2514B-AEZC-TR; LCSC C16251
Y1: 24MHz; Crystal_SMD_3225-4Pin_3.2x2.5mm; MPN X322524MSB4SI; LCSC C15643

Connections:
+3V3: C6.1, C7.1, C8.1, C9.1, C10.1, C11.1, C12.1, R7.1, R12.1, U3.5 (VDDA33), U3.10 (VDDA33), U3.15 (VDD33), U3.23 (VDD33), U3.29 (VDDA33), U3.36 (VDDA33); also elsewhere on the board
+5V: R8.1; also elsewhere on the board
/Hub/FT1_PRTPWR: R14.1, U3.20 (PRTPWR4/BC_EN4)
/Hub/FT2_PRTPWR: R15.1, U3.18 (PRTPWR3/BC_EN3)
/Hub/FT3_PRTPWR: R16.1, U3.12 (PRTPWR1/BC_EN1)
/Hub/FT4_PRTPWR: R17.1, U3.16 (PRTPWR2/BC_EN2)
/Hub/HUB_CFG_SEL0: R11.1, U3.24 (SCL/SMBCLK/CFG_SEL0)
/Hub/HUB_CFG_SEL1: R12.2, U3.25 (HS_IND/CFG_SEL1)
/Hub/HUB_CRFILT: C13.1, U3.14 (CRFILT)
/Hub/HUB_NON_REM0: R13.1, U3.28 (SUSP_IND/LOCAL_PWR/NON_REM0)
/Hub/HUB_NON_REM1: R10.1, U3.22 (SDA/SMBDATA/NON_REM1)
/Hub/HUB_PLLFILT: C14.1, U3.34 (PLLFILT)
/Hub/HUB_RBIAS: R6.1, U3.35 (RBIAS)
/Hub/HUB_RESET_N: C17.1, R7.2, U3.26 (RESET_N)
/Hub/HUB_VBUS_DET: R8.2, R9.1, U3.27 (VBUS_DET)
/Hub/HUB_XI: C15.1, U3.33 (XTALIN/CLKIN), Y1.1
/Hub/HUB_XO: C16.1, U3.32 (XTALOUT), Y1.3
FT1_DM: U3.8 (USBDM_DN4/PRT_DIS_M4); also elsewhere on the board
FT1_DP: U3.9 (USBDP_DN4/PRT_DIS_P4); also elsewhere on the board
FT1_RESET_N: R14.2; also elsewhere on the board
FT2_DM: U3.6 (USBDM_DN3/PRT_DIS_M3); also elsewhere on the board
FT2_DP: U3.7 (USBDP_DN3/PRT_DIS_P3); also elsewhere on the board
FT2_RESET_N: R15.2; also elsewhere on the board
FT3_DM: U3.1 (USBDM_DN1/PRT_DIS_M1); also elsewhere on the board
FT3_DP: U3.2 (USBDP_DN1/PRT_DIS_P1); also elsewhere on the board
FT3_RESET_N: R16.2; also elsewhere on the board
FT4_DM: U3.3 (USBDM_DN2/PRT_DIS_M2); also elsewhere on the board
FT4_DP: U3.4 (USBDP_DN2/PRT_DIS_P2); also elsewhere on the board
FT4_RESET_N: R17.2; also elsewhere on the board
GND: C6.2, C7.2, C8.2, C9.2, C10.2, C11.2, C12.2, C13.2, C14.2, C15.2, C16.2, C17.2, R6.2, R9.2, R10.2, R11.2, R13.2, U3.11 (TEST), U3.37 (VSS), Y1.2 (G), Y1.4 (G); also elsewhere on the board
USB_UP_DM: U3.30 (USBDM_UP); also elsewhere on the board
USB_UP_DP: U3.31 (USBDP_UP); also elsewhere on the board

Notes on the sheet:
CFG_SEL[1:0]=10: default config, bus powered. NON_REM=00. BC_EN=0 (PRTPWR not pulled up).
Hub port 1..4 -> FT3, FT4, FT2, FT1 (uhubctl -p N).
PRTPWR -> FT RESET# 0R links are DNP: fit them and remove the FT RESET# pull-up for hard reset.

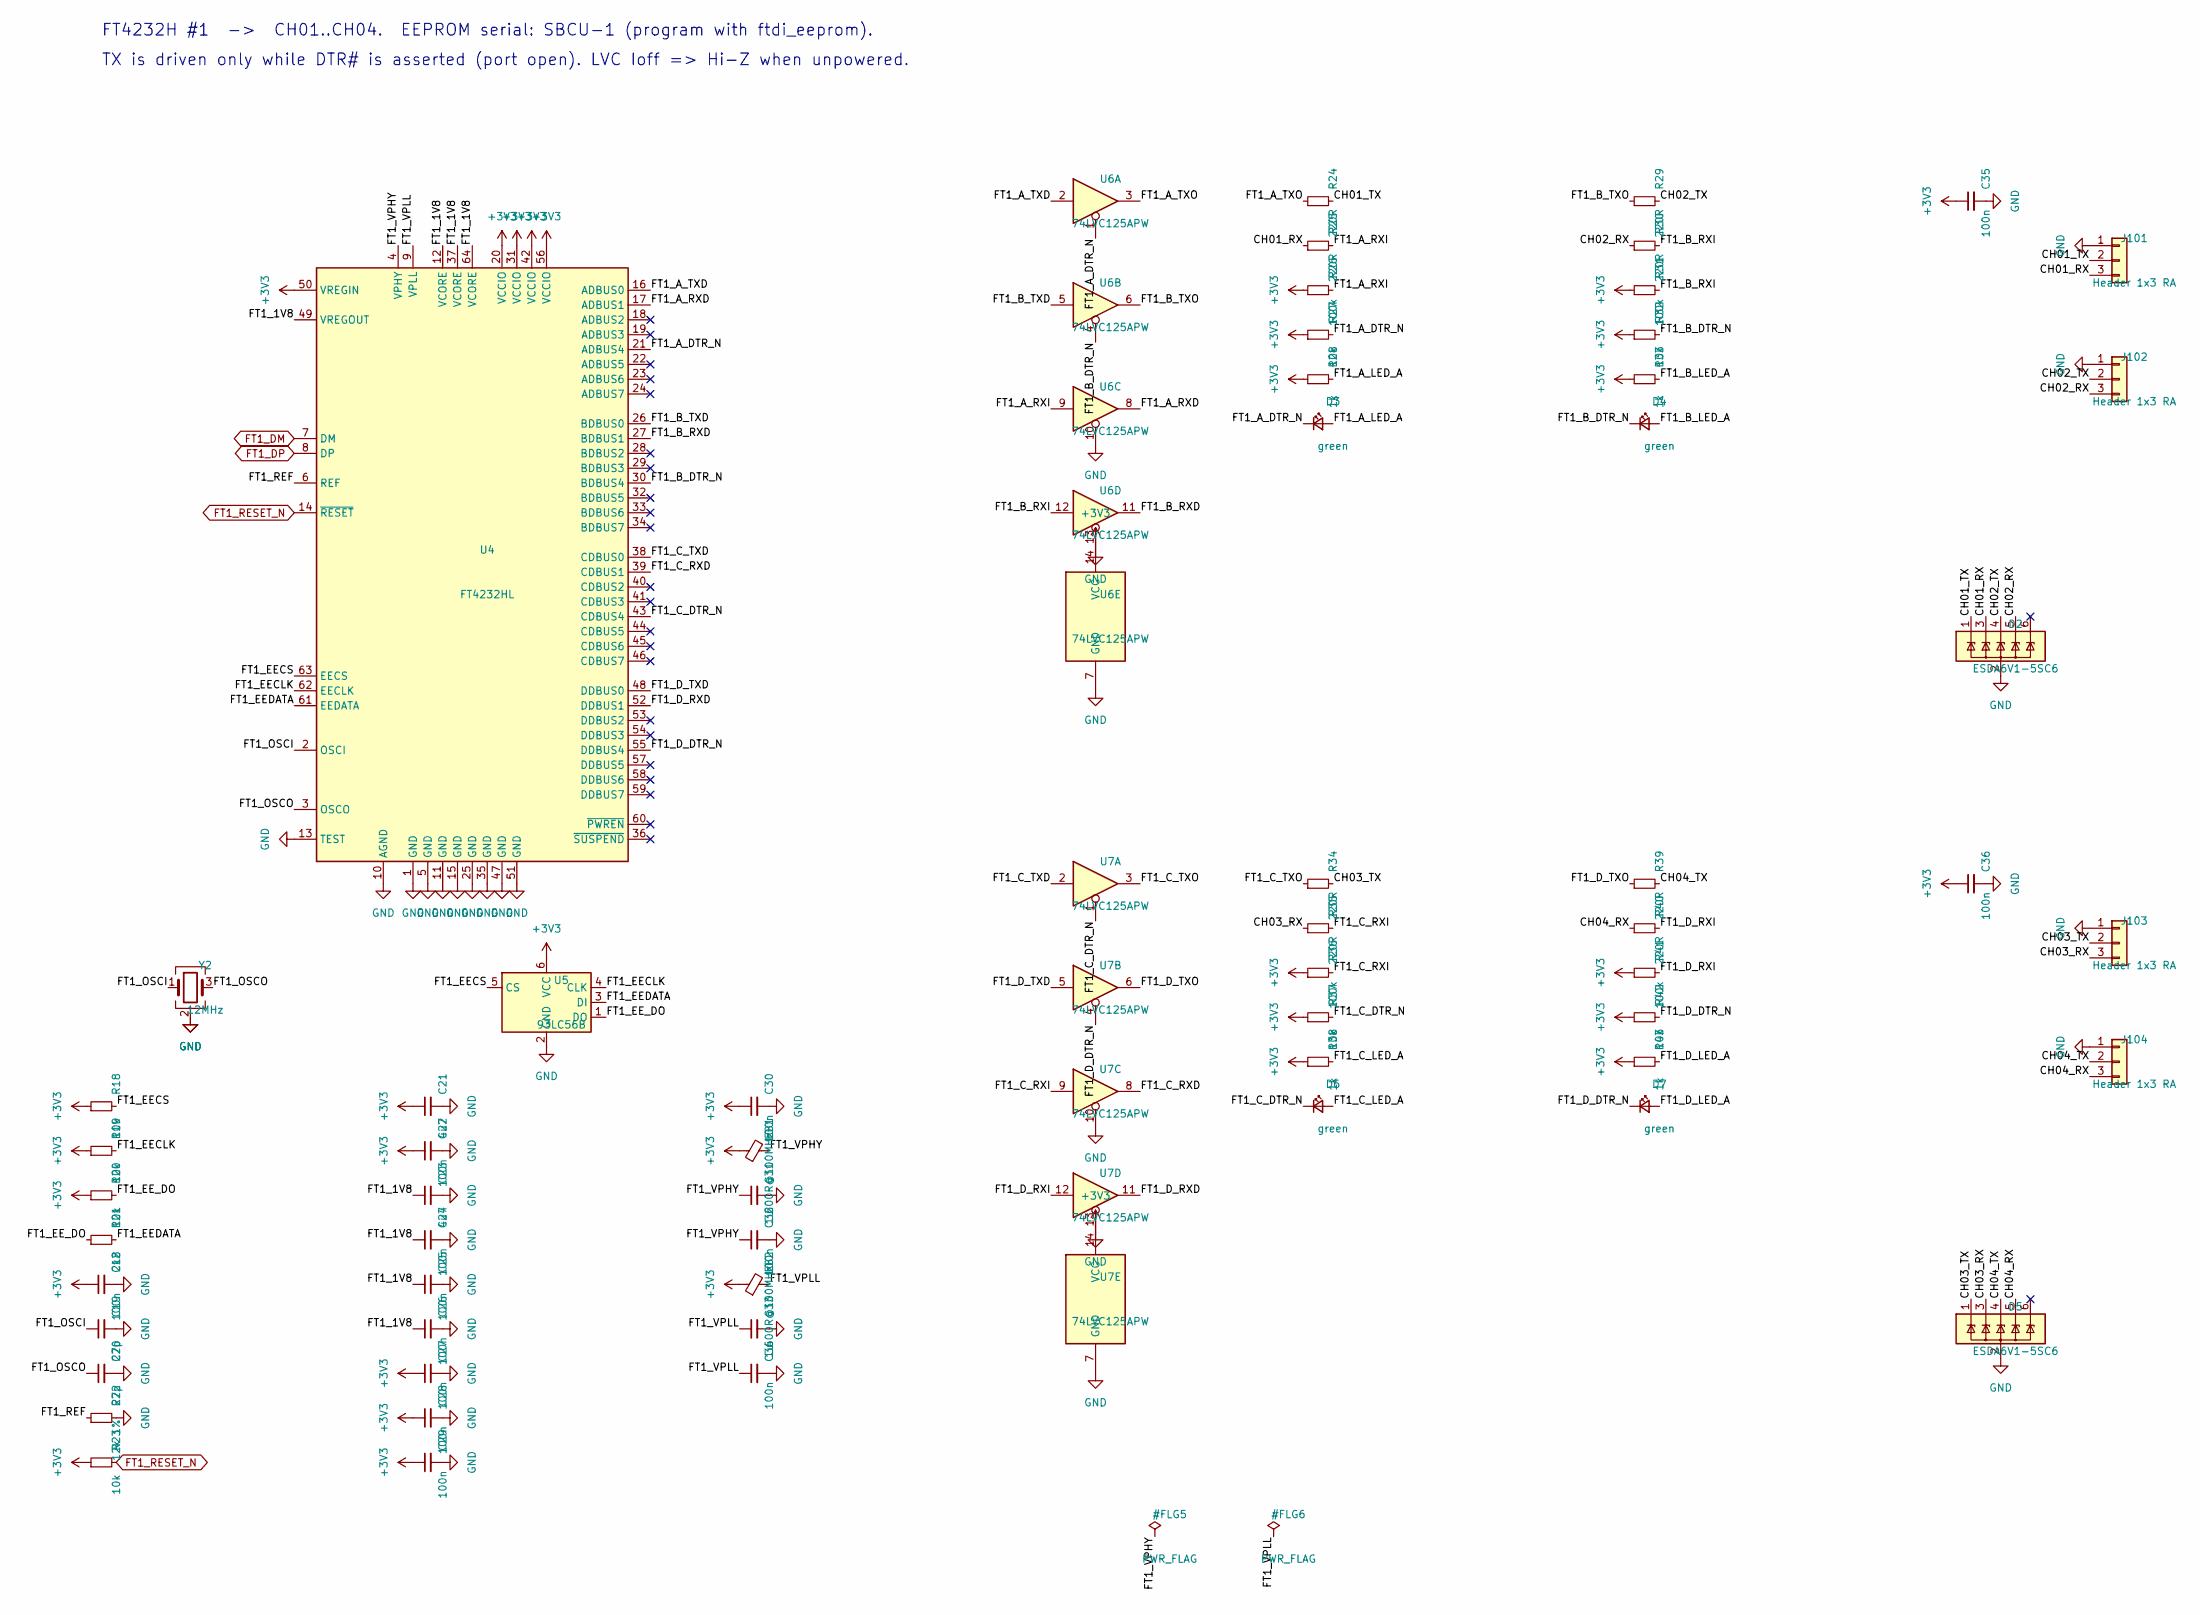
[picture p15: schematic ft1.kicad_sch, FT4232H #1: channels 01-04]

Parts:
C18, C22, C24, C25, C26, C27, C28, C29, C30, C32, C34, C35, C36: 100n; C_0402_1005Metric; MPN CL05B104KO5NNNC; LCSC C1525
C19, C20: 27p; C_0402_1005Metric; MPN 0402CG270J500NT; LCSC C1557
C21, C23: 4u7; C_0805_2012Metric; MPN CL21A475KAQNNNE; LCSC C1779
C31, C33: 1u; C_0402_1005Metric; MPN CL05A105KA5NQNC; LCSC C52923
D2, D5: ESDA6V1-5SC6; SOT-23-6; MPN ESDA6V1-5SC6; LCSC C2827672
D3, D4, D6, D7: green; LED_0603_1608Metric; MPN KT-0603G; LCSC C12624
FB1, FB2: 600R@100MHz; L_0603_1608Metric; MPN GZ1608D601TF; LCSC C1002
J101, J102, J103, J104: Header 1x3 RA; PinHeader_1x03_P2.54mm_Horizontal_Edge; MPN PZ254R-11-03P; LCSC C492411
R18, R19, R20, R23, R27, R32, R37, R42: 10k; R_0402_1005Metric; MPN 0402WGF1002TCE; LCSC C25744
R21: 2k2; R_0402_1005Metric; MPN 0402WGF2201TCE; LCSC C25879
R22: 12k 1%; R_0402_1005Metric; MPN 0402WGF1202TCE; LCSC C25752
R24, R25, R29, R30, R34, R35, R39, R40: 220R; R_0402_1005Metric; MPN 0402WGF2200TCE; LCSC C25091
R26, R31, R36, R41: 100k; R_0402_1005Metric; MPN 0402WGF1003TCE; LCSC C25741
R28, R33, R38, R43: 1k; R_0402_1005Metric; MPN 0402WGF1001TCE; LCSC C11702
U4: FT4232HL; LQFP-64_10x10mm_P0.5mm; MPN FT4232HL-REEL; LCSC C56742
U5: 93LC56B; SOT-23-6; MPN 93LC56BT-I/OT; LCSC C190271
U6, U7: 74LVC125APW; TSSOP-14_4.4x5mm_P0.65mm; MPN 74LVC125APW,118; LCSC C6059
Y2: 12MHz; Crystal_SMD_3225-4Pin_3.2x2.5mm; MPN X322512MSB4SI; LCSC C9002

Connections:
+3V3: C18.1, C21.1, C22.1, C27.1, C28.1, C29.1, C30.1, C35.1, C36.1, FB1.1, FB2.1, R18.1, R19.1, R20.1, R23.1, R26.1, R27.1, R28.1, R31.1, R32.1, R33.1, R36.1, R37.1, R38.1, R41.1, R42.1, R43.1, U4.20 (VCCIO), U4.31 (VCCIO), U4.42 (VCCIO), U4.50 (VREGIN), U4.56 (VCCIO), U5.6 (VCC), U6.14 (VCC), U7.14 (VCC); also elsewhere on the board
/FT1/CH01_RX: D2.3 (IO2), J101.3, R25.1
/FT1/CH01_TX: D2.1 (IO1), J101.2, R24.2
/FT1/CH02_RX: D2.5 (IO4), J102.3, R30.1
/FT1/CH02_TX: D2.4 (IO3), J102.2, R29.2
/FT1/CH03_RX: D5.3 (IO2), J103.3, R35.1
/FT1/CH03_TX: D5.1 (IO1), J103.2, R34.2
/FT1/CH04_RX: D5.5 (IO4), J104.3, R40.1
/FT1/CH04_TX: D5.4 (IO3), J104.2, R39.2
/FT1/FT1_1V8: C23.1, C24.1, C25.1, C26.1, U4.12 (VCORE), U4.37 (VCORE), U4.49 (VREGOUT), U4.64 (VCORE)
/FT1/FT1_A_DTR_N: D3.1 (K), R27.2, U4.21 (ADBUS4), U6.1
/FT1/FT1_A_LED_A: D3.2 (A), R28.2
/FT1/FT1_A_RXD: U4.17 (ADBUS1), U6.8
/FT1/FT1_A_RXI: R25.2, R26.2, U6.9
/FT1/FT1_A_TXD: U4.16 (ADBUS0), U6.2
/FT1/FT1_A_TXO: R24.1, U6.3
/FT1/FT1_B_DTR_N: D4.1 (K), R32.2, U4.30 (BDBUS4), U6.4
/FT1/FT1_B_LED_A: D4.2 (A), R33.2
/FT1/FT1_B_RXD: U4.27 (BDBUS1), U6.11
/FT1/FT1_B_RXI: R30.2, R31.2, U6.12
/FT1/FT1_B_TXD: U4.26 (BDBUS0), U6.5
/FT1/FT1_B_TXO: R29.1, U6.6
/FT1/FT1_C_DTR_N: D6.1 (K), R37.2, U4.43 (CDBUS4), U7.1
/FT1/FT1_C_LED_A: D6.2 (A), R38.2
/FT1/FT1_C_RXD: U4.39 (CDBUS1), U7.8
/FT1/FT1_C_RXI: R35.2, R36.2, U7.9
/FT1/FT1_C_TXD: U4.38 (CDBUS0), U7.2
/FT1/FT1_C_TXO: R34.1, U7.3
/FT1/FT1_D_DTR_N: D7.1 (K), R42.2, U4.55 (DDBUS4), U7.4
/FT1/FT1_D_LED_A: D7.2 (A), R43.2
/FT1/FT1_D_RXD: U4.52 (DDBUS1), U7.11
/FT1/FT1_D_RXI: R40.2, R41.2, U7.12
/FT1/FT1_D_TXD: U4.48 (DDBUS0), U7.5
/FT1/FT1_D_TXO: R39.1, U7.6
/FT1/FT1_EECLK: R19.2, U4.62 (EECLK), U5.4 (CLK)
/FT1/FT1_EECS: R18.2, U4.63 (EECS), U5.5 (CS)
/FT1/FT1_EEDATA: R21.2, U4.61 (EEDATA), U5.3 (DI)
/FT1/FT1_EE_DO: R20.2, R21.1, U5.1 (DO)
/FT1/FT1_OSCI: C19.1, U4.2 (OSCI), Y2.1
/FT1/FT1_OSCO: C20.1, U4.3 (OSCO), Y2.3
/FT1/FT1_REF: R22.1, U4.6 (REF)
/FT1/FT1_VPHY: C31.1, C32.1, FB1.2, U4.4 (VPHY)
/FT1/FT1_VPLL: C33.1, C34.1, FB2.2, U4.9 (VPLL)
FT1_DM: U4.7 (DM); also elsewhere on the board
FT1_DP: U4.8 (DP); also elsewhere on the board
FT1_RESET_N: R23.2, U4.14 (~RESET); also elsewhere on the board
GND: C18.2, C19.2, C20.2, C21.2, C22.2, C23.2, C24.2, C25.2, C26.2, C27.2, C28.2, C29.2, C30.2, C31.2, C32.2, C33.2, C34.2, C35.2, C36.2, D2.2 (GND), D5.2 (GND), J101.1, J102.1, J103.1, J104.1, R22.2, U4.1 (GND), U4.5 (GND), U4.10 (AGND), U4.11 (GND), U4.13 (TEST), U4.15 (GND), U4.25 (GND), U4.35 (GND), U4.47 (GND), U4.51 (GND), U5.2 (GND), U6.7 (GND), U6.10, U6.13, U7.7 (GND), U7.10, U7.13, Y2.2 (G), Y2.4 (G); also elsewhere on the board

Notes on the sheet:
FT4232H #1 -> CH01..CH04. EEPROM serial: SBCU-1 (program with ftdi_eeprom).
TX is driven only while DTR# is asserted (port open). LVC Ioff => Hi-Z when unpowered.

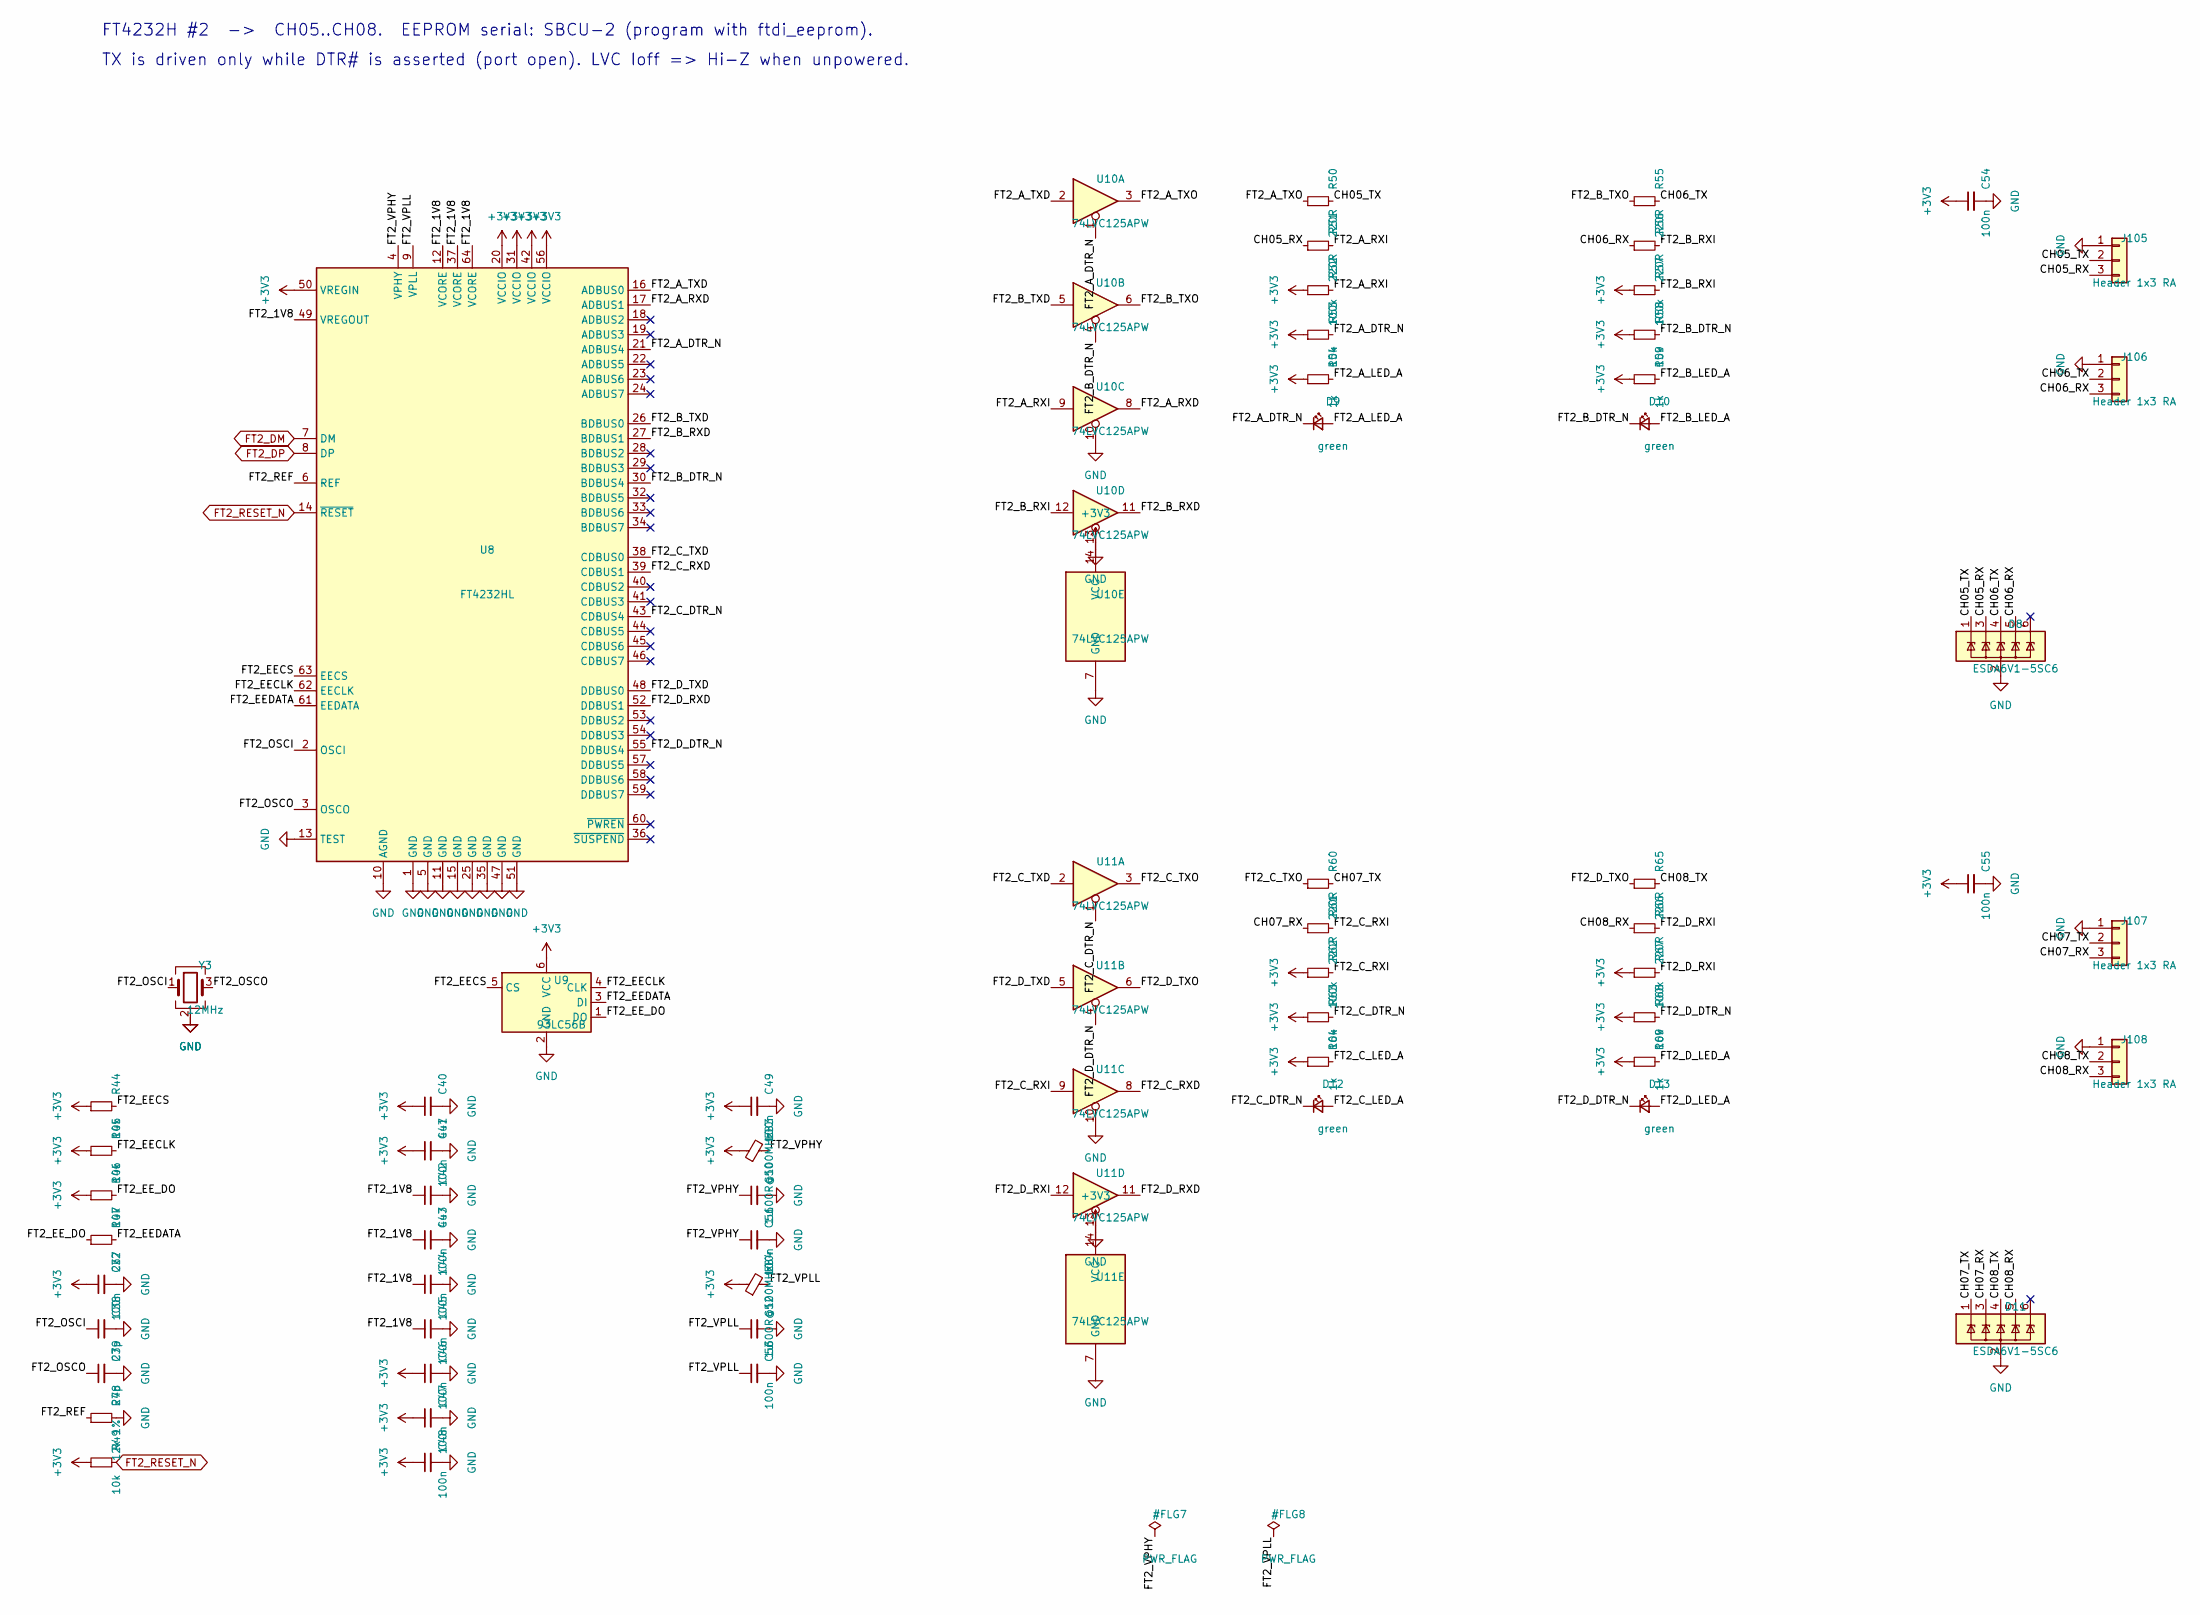
[picture p16: schematic ft2.kicad_sch, FT4232H #2: channels 05-08]

Parts:
C37, C41, C43, C44, C45, C46, C47, C48, C49, C51, C53, C54, C55: 100n; C_0402_1005Metric; MPN CL05B104KO5NNNC; LCSC C1525
C38, C39: 27p; C_0402_1005Metric; MPN 0402CG270J500NT; LCSC C1557
C40, C42: 4u7; C_0805_2012Metric; MPN CL21A475KAQNNNE; LCSC C1779
C50, C52: 1u; C_0402_1005Metric; MPN CL05A105KA5NQNC; LCSC C52923
D8, D11: ESDA6V1-5SC6; SOT-23-6; MPN ESDA6V1-5SC6; LCSC C2827672
D9, D10, D12, D13: green; LED_0603_1608Metric; MPN KT-0603G; LCSC C12624
FB3, FB4: 600R@100MHz; L_0603_1608Metric; MPN GZ1608D601TF; LCSC C1002
J105, J106, J107, J108: Header 1x3 RA; PinHeader_1x03_P2.54mm_Horizontal_Edge; MPN PZ254R-11-03P; LCSC C492411
R44, R45, R46, R49, R53, R58, R63, R68: 10k; R_0402_1005Metric; MPN 0402WGF1002TCE; LCSC C25744
R47: 2k2; R_0402_1005Metric; MPN 0402WGF2201TCE; LCSC C25879
R48: 12k 1%; R_0402_1005Metric; MPN 0402WGF1202TCE; LCSC C25752
R50, R51, R55, R56, R60, R61, R65, R66: 220R; R_0402_1005Metric; MPN 0402WGF2200TCE; LCSC C25091
R52, R57, R62, R67: 100k; R_0402_1005Metric; MPN 0402WGF1003TCE; LCSC C25741
R54, R59, R64, R69: 1k; R_0402_1005Metric; MPN 0402WGF1001TCE; LCSC C11702
U8: FT4232HL; LQFP-64_10x10mm_P0.5mm; MPN FT4232HL-REEL; LCSC C56742
U9: 93LC56B; SOT-23-6; MPN 93LC56BT-I/OT; LCSC C190271
U10, U11: 74LVC125APW; TSSOP-14_4.4x5mm_P0.65mm; MPN 74LVC125APW,118; LCSC C6059
Y3: 12MHz; Crystal_SMD_3225-4Pin_3.2x2.5mm; MPN X322512MSB4SI; LCSC C9002

Connections:
+3V3: C37.1, C40.1, C41.1, C46.1, C47.1, C48.1, C49.1, C54.1, C55.1, FB3.1, FB4.1, R44.1, R45.1, R46.1, R49.1, R52.1, R53.1, R54.1, R57.1, R58.1, R59.1, R62.1, R63.1, R64.1, R67.1, R68.1, R69.1, U8.20 (VCCIO), U8.31 (VCCIO), U8.42 (VCCIO), U8.50 (VREGIN), U8.56 (VCCIO), U9.6 (VCC), U10.14 (VCC), U11.14 (VCC); also elsewhere on the board
/FT2/CH05_RX: D8.3 (IO2), J105.3, R51.1
/FT2/CH05_TX: D8.1 (IO1), J105.2, R50.2
/FT2/CH06_RX: D8.5 (IO4), J106.3, R56.1
/FT2/CH06_TX: D8.4 (IO3), J106.2, R55.2
/FT2/CH07_RX: D11.3 (IO2), J107.3, R61.1
/FT2/CH07_TX: D11.1 (IO1), J107.2, R60.2
/FT2/CH08_RX: D11.5 (IO4), J108.3, R66.1
/FT2/CH08_TX: D11.4 (IO3), J108.2, R65.2
/FT2/FT2_1V8: C42.1, C43.1, C44.1, C45.1, U8.12 (VCORE), U8.37 (VCORE), U8.49 (VREGOUT), U8.64 (VCORE)
/FT2/FT2_A_DTR_N: D9.1 (K), R53.2, U8.21 (ADBUS4), U10.1
/FT2/FT2_A_LED_A: D9.2 (A), R54.2
/FT2/FT2_A_RXD: U8.17 (ADBUS1), U10.8
/FT2/FT2_A_RXI: R51.2, R52.2, U10.9
/FT2/FT2_A_TXD: U8.16 (ADBUS0), U10.2
/FT2/FT2_A_TXO: R50.1, U10.3
/FT2/FT2_B_DTR_N: D10.1 (K), R58.2, U8.30 (BDBUS4), U10.4
/FT2/FT2_B_LED_A: D10.2 (A), R59.2
/FT2/FT2_B_RXD: U8.27 (BDBUS1), U10.11
/FT2/FT2_B_RXI: R56.2, R57.2, U10.12
/FT2/FT2_B_TXD: U8.26 (BDBUS0), U10.5
/FT2/FT2_B_TXO: R55.1, U10.6
/FT2/FT2_C_DTR_N: D12.1 (K), R63.2, U8.43 (CDBUS4), U11.1
/FT2/FT2_C_LED_A: D12.2 (A), R64.2
/FT2/FT2_C_RXD: U8.39 (CDBUS1), U11.8
/FT2/FT2_C_RXI: R61.2, R62.2, U11.9
/FT2/FT2_C_TXD: U8.38 (CDBUS0), U11.2
/FT2/FT2_C_TXO: R60.1, U11.3
/FT2/FT2_D_DTR_N: D13.1 (K), R68.2, U8.55 (DDBUS4), U11.4
/FT2/FT2_D_LED_A: D13.2 (A), R69.2
/FT2/FT2_D_RXD: U8.52 (DDBUS1), U11.11
/FT2/FT2_D_RXI: R66.2, R67.2, U11.12
/FT2/FT2_D_TXD: U8.48 (DDBUS0), U11.5
/FT2/FT2_D_TXO: R65.1, U11.6
/FT2/FT2_EECLK: R45.2, U8.62 (EECLK), U9.4 (CLK)
/FT2/FT2_EECS: R44.2, U8.63 (EECS), U9.5 (CS)
/FT2/FT2_EEDATA: R47.2, U8.61 (EEDATA), U9.3 (DI)
/FT2/FT2_EE_DO: R46.2, R47.1, U9.1 (DO)
/FT2/FT2_OSCI: C38.1, U8.2 (OSCI), Y3.1
/FT2/FT2_OSCO: C39.1, U8.3 (OSCO), Y3.3
/FT2/FT2_REF: R48.1, U8.6 (REF)
/FT2/FT2_VPHY: C50.1, C51.1, FB3.2, U8.4 (VPHY)
/FT2/FT2_VPLL: C52.1, C53.1, FB4.2, U8.9 (VPLL)
FT2_DM: U8.7 (DM); also elsewhere on the board
FT2_DP: U8.8 (DP); also elsewhere on the board
FT2_RESET_N: R49.2, U8.14 (~RESET); also elsewhere on the board
GND: C37.2, C38.2, C39.2, C40.2, C41.2, C42.2, C43.2, C44.2, C45.2, C46.2, C47.2, C48.2, C49.2, C50.2, C51.2, C52.2, C53.2, C54.2, C55.2, D8.2 (GND), D11.2 (GND), J105.1, J106.1, J107.1, J108.1, R48.2, U8.1 (GND), U8.5 (GND), U8.10 (AGND), U8.11 (GND), U8.13 (TEST), U8.15 (GND), U8.25 (GND), U8.35 (GND), U8.47 (GND), U8.51 (GND), U9.2 (GND), U10.7 (GND), U10.10, U10.13, U11.7 (GND), U11.10, U11.13, Y3.2 (G), Y3.4 (G); also elsewhere on the board

Notes on the sheet:
FT4232H #2 -> CH05..CH08. EEPROM serial: SBCU-2 (program with ftdi_eeprom).
TX is driven only while DTR# is asserted (port open). LVC Ioff => Hi-Z when unpowered.
