jernejsk/sbc-uart-hub/hw/sbc-uart-hub.kicad_pcb

## KiCad design hw/sbc-uart-hub.kicad_pcb (continued)

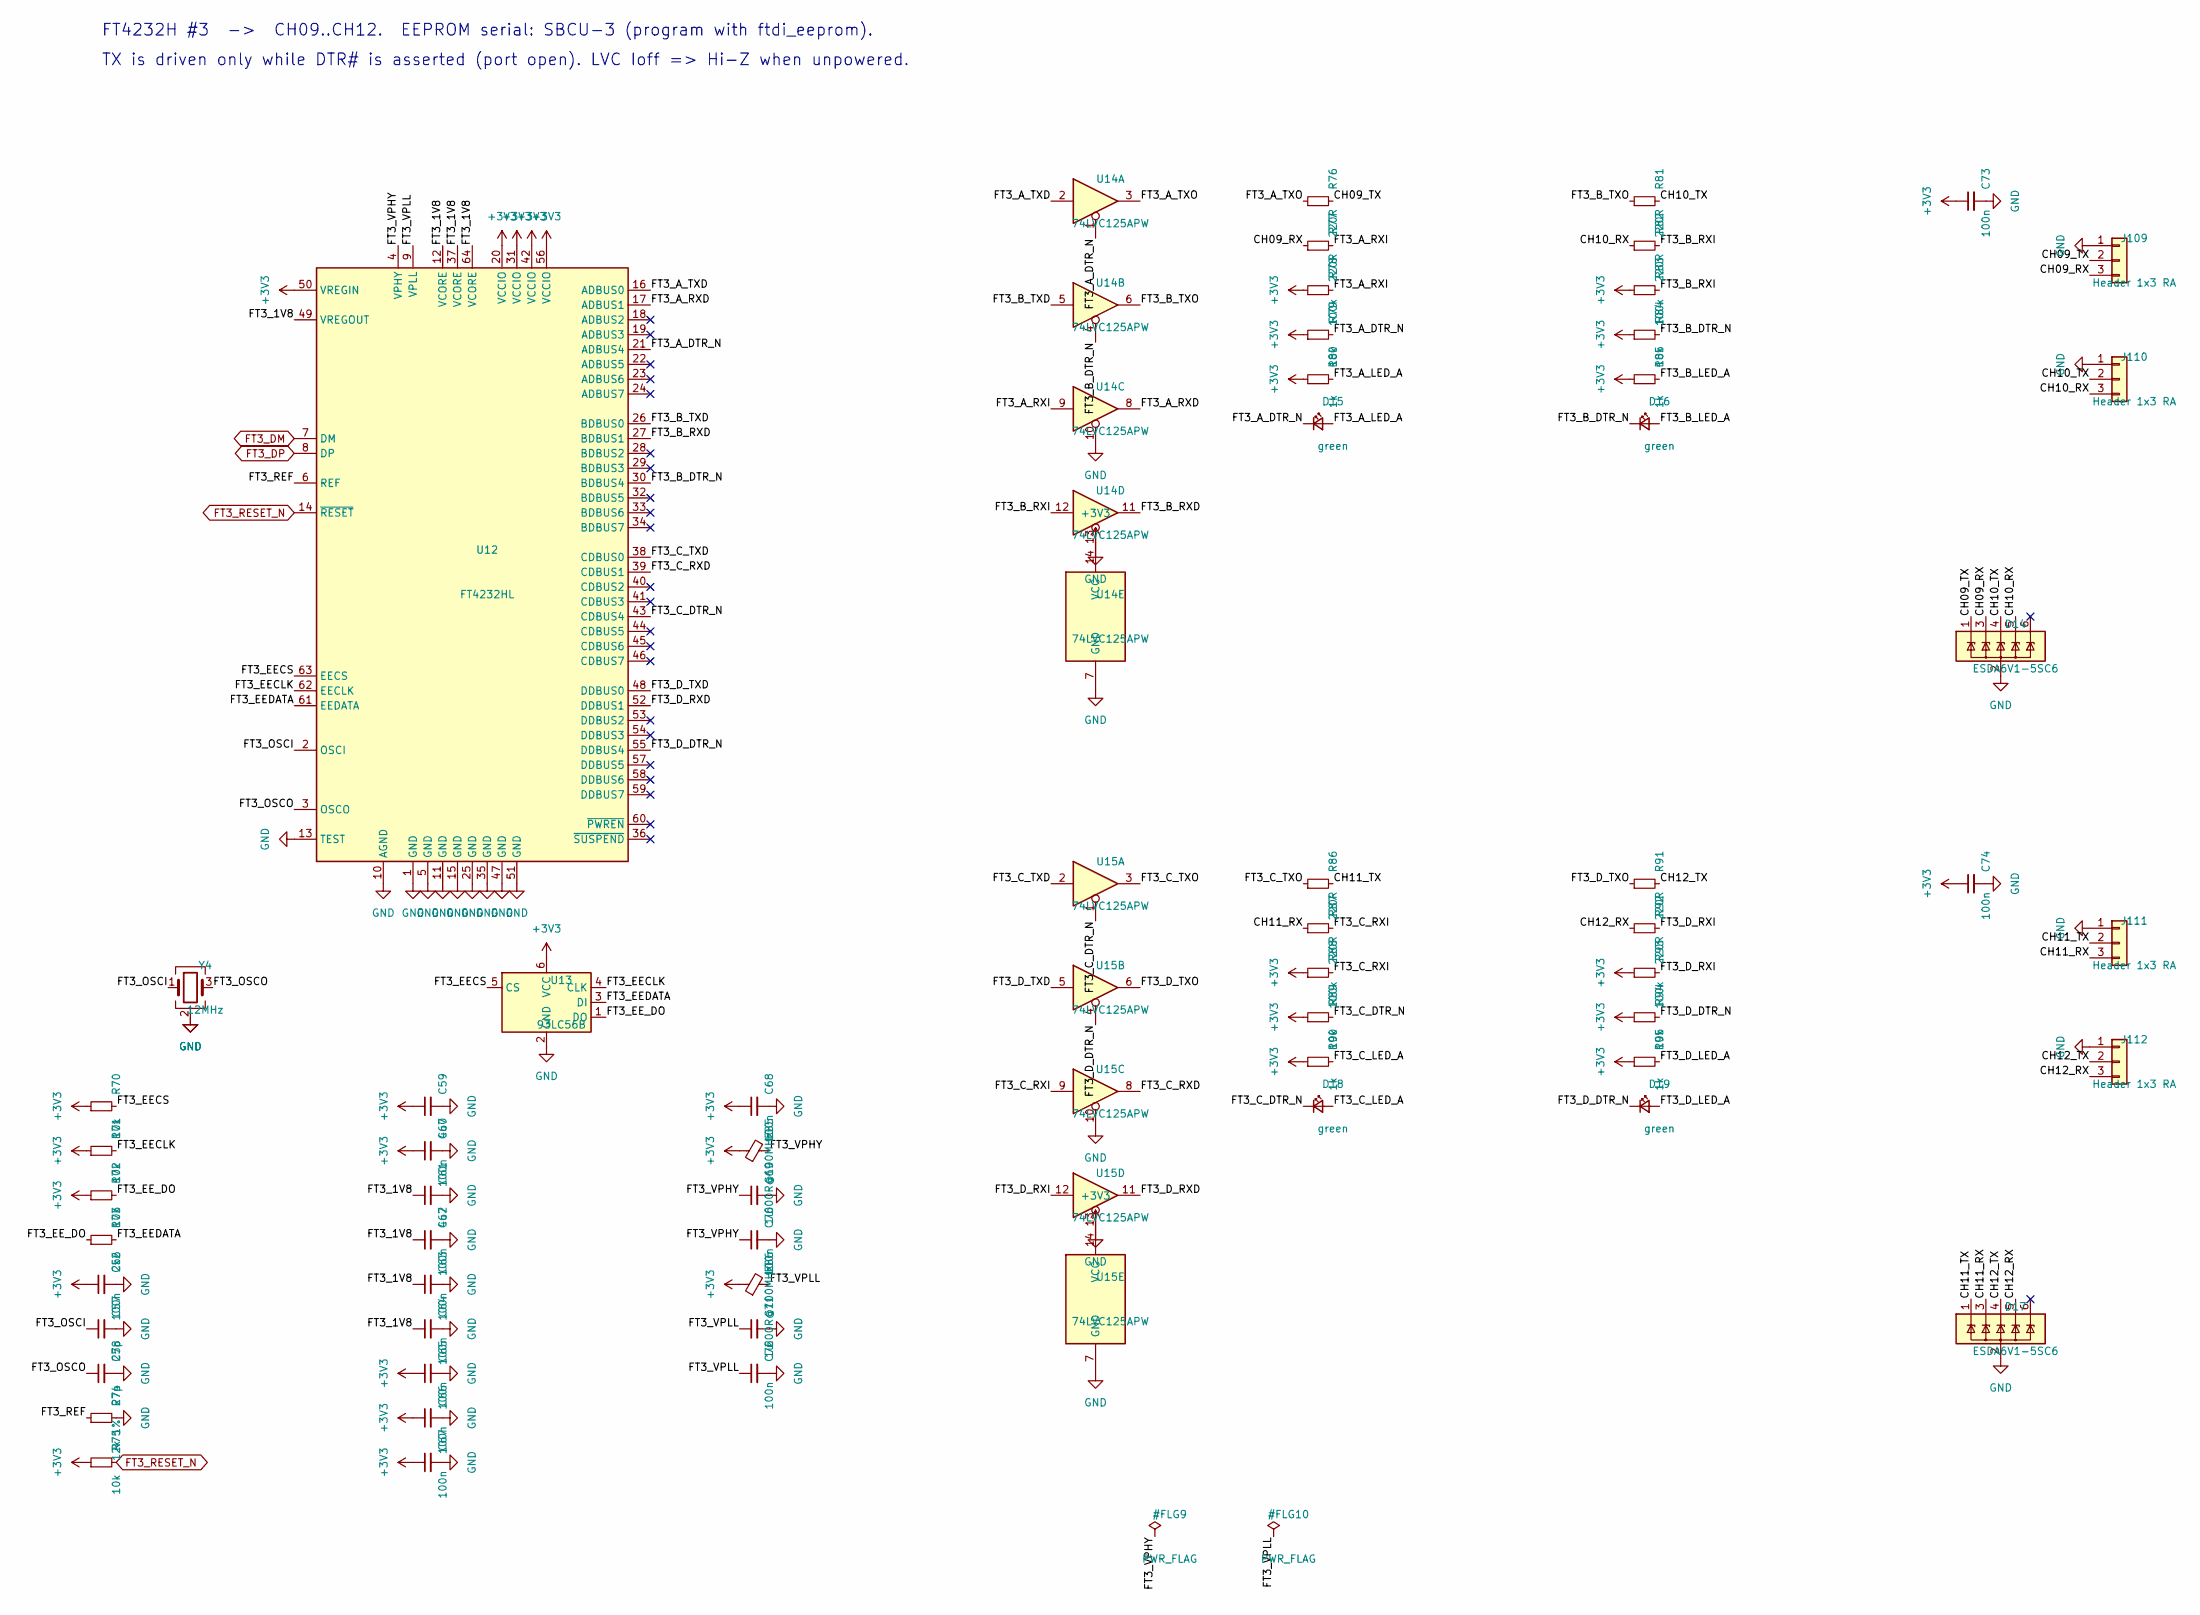
[picture p17: schematic ft3.kicad_sch, FT4232H #3: channels 09-12]

Parts:
C56, C60, C62, C63, C64, C65, C66, C67, C68, C70, C72, C73, C74: 100n; C_0402_1005Metric; MPN CL05B104KO5NNNC; LCSC C1525
C57, C58: 27p; C_0402_1005Metric; MPN 0402CG270J500NT; LCSC C1557
C59, C61: 4u7; C_0805_2012Metric; MPN CL21A475KAQNNNE; LCSC C1779
C69, C71: 1u; C_0402_1005Metric; MPN CL05A105KA5NQNC; LCSC C52923
D14, D17: ESDA6V1-5SC6; SOT-23-6; MPN ESDA6V1-5SC6; LCSC C2827672
D15, D16, D18, D19: green; LED_0603_1608Metric; MPN KT-0603G; LCSC C12624
FB5, FB6: 600R@100MHz; L_0603_1608Metric; MPN GZ1608D601TF; LCSC C1002
J109, J110, J111, J112: Header 1x3 RA; PinHeader_1x03_P2.54mm_Horizontal_Edge; MPN PZ254R-11-03P; LCSC C492411
R70, R71, R72, R75, R79, R84, R89, R94: 10k; R_0402_1005Metric; MPN 0402WGF1002TCE; LCSC C25744
R73: 2k2; R_0402_1005Metric; MPN 0402WGF2201TCE; LCSC C25879
R74: 12k 1%; R_0402_1005Metric; MPN 0402WGF1202TCE; LCSC C25752
R76, R77, R81, R82, R86, R87, R91, R92: 220R; R_0402_1005Metric; MPN 0402WGF2200TCE; LCSC C25091
R78, R83, R88, R93: 100k; R_0402_1005Metric; MPN 0402WGF1003TCE; LCSC C25741
R80, R85, R90, R95: 1k; R_0402_1005Metric; MPN 0402WGF1001TCE; LCSC C11702
U12: FT4232HL; LQFP-64_10x10mm_P0.5mm; MPN FT4232HL-REEL; LCSC C56742
U13: 93LC56B; SOT-23-6; MPN 93LC56BT-I/OT; LCSC C190271
U14, U15: 74LVC125APW; TSSOP-14_4.4x5mm_P0.65mm; MPN 74LVC125APW,118; LCSC C6059
Y4: 12MHz; Crystal_SMD_3225-4Pin_3.2x2.5mm; MPN X322512MSB4SI; LCSC C9002

Connections:
+3V3: C56.1, C59.1, C60.1, C65.1, C66.1, C67.1, C68.1, C73.1, C74.1, FB5.1, FB6.1, R70.1, R71.1, R72.1, R75.1, R78.1, R79.1, R80.1, R83.1, R84.1, R85.1, R88.1, R89.1, R90.1, R93.1, R94.1, R95.1, U12.20 (VCCIO), U12.31 (VCCIO), U12.42 (VCCIO), U12.50 (VREGIN), U12.56 (VCCIO), U13.6 (VCC), U14.14 (VCC), U15.14 (VCC); also elsewhere on the board
/FT3/CH09_RX: D14.3 (IO2), J109.3, R77.1
/FT3/CH09_TX: D14.1 (IO1), J109.2, R76.2
/FT3/CH10_RX: D14.5 (IO4), J110.3, R82.1
/FT3/CH10_TX: D14.4 (IO3), J110.2, R81.2
/FT3/CH11_RX: D17.3 (IO2), J111.3, R87.1
/FT3/CH11_TX: D17.1 (IO1), J111.2, R86.2
/FT3/CH12_RX: D17.5 (IO4), J112.3, R92.1
/FT3/CH12_TX: D17.4 (IO3), J112.2, R91.2
/FT3/FT3_1V8: C61.1, C62.1, C63.1, C64.1, U12.12 (VCORE), U12.37 (VCORE), U12.49 (VREGOUT), U12.64 (VCORE)
/FT3/FT3_A_DTR_N: D15.1 (K), R79.2, U12.21 (ADBUS4), U14.1
/FT3/FT3_A_LED_A: D15.2 (A), R80.2
/FT3/FT3_A_RXD: U12.17 (ADBUS1), U14.8
/FT3/FT3_A_RXI: R77.2, R78.2, U14.9
/FT3/FT3_A_TXD: U12.16 (ADBUS0), U14.2
/FT3/FT3_A_TXO: R76.1, U14.3
/FT3/FT3_B_DTR_N: D16.1 (K), R84.2, U12.30 (BDBUS4), U14.4
/FT3/FT3_B_LED_A: D16.2 (A), R85.2
/FT3/FT3_B_RXD: U12.27 (BDBUS1), U14.11
/FT3/FT3_B_RXI: R82.2, R83.2, U14.12
/FT3/FT3_B_TXD: U12.26 (BDBUS0), U14.5
/FT3/FT3_B_TXO: R81.1, U14.6
/FT3/FT3_C_DTR_N: D18.1 (K), R89.2, U12.43 (CDBUS4), U15.1
/FT3/FT3_C_LED_A: D18.2 (A), R90.2
/FT3/FT3_C_RXD: U12.39 (CDBUS1), U15.8
/FT3/FT3_C_RXI: R87.2, R88.2, U15.9
/FT3/FT3_C_TXD: U12.38 (CDBUS0), U15.2
/FT3/FT3_C_TXO: R86.1, U15.3
/FT3/FT3_D_DTR_N: D19.1 (K), R94.2, U12.55 (DDBUS4), U15.4
/FT3/FT3_D_LED_A: D19.2 (A), R95.2
/FT3/FT3_D_RXD: U12.52 (DDBUS1), U15.11
/FT3/FT3_D_RXI: R92.2, R93.2, U15.12
/FT3/FT3_D_TXD: U12.48 (DDBUS0), U15.5
/FT3/FT3_D_TXO: R91.1, U15.6
/FT3/FT3_EECLK: R71.2, U12.62 (EECLK), U13.4 (CLK)
/FT3/FT3_EECS: R70.2, U12.63 (EECS), U13.5 (CS)
/FT3/FT3_EEDATA: R73.2, U12.61 (EEDATA), U13.3 (DI)
/FT3/FT3_EE_DO: R72.2, R73.1, U13.1 (DO)
/FT3/FT3_OSCI: C57.1, U12.2 (OSCI), Y4.1
/FT3/FT3_OSCO: C58.1, U12.3 (OSCO), Y4.3
/FT3/FT3_REF: R74.1, U12.6 (REF)
/FT3/FT3_VPHY: C69.1, C70.1, FB5.2, U12.4 (VPHY)
/FT3/FT3_VPLL: C71.1, C72.1, FB6.2, U12.9 (VPLL)
FT3_DM: U12.7 (DM); also elsewhere on the board
FT3_DP: U12.8 (DP); also elsewhere on the board
FT3_RESET_N: R75.2, U12.14 (~RESET); also elsewhere on the board
GND: C56.2, C57.2, C58.2, C59.2, C60.2, C61.2, C62.2, C63.2, C64.2, C65.2, C66.2, C67.2, C68.2, C69.2, C70.2, C71.2, C72.2, C73.2, C74.2, D14.2 (GND), D17.2 (GND), J109.1, J110.1, J111.1, J112.1, R74.2, U12.1 (GND), U12.5 (GND), U12.10 (AGND), U12.11 (GND), U12.13 (TEST), U12.15 (GND), U12.25 (GND), U12.35 (GND), U12.47 (GND), U12.51 (GND), U13.2 (GND), U14.7 (GND), U14.10, U14.13, U15.7 (GND), U15.10, U15.13, Y4.2 (G), Y4.4 (G); also elsewhere on the board

Notes on the sheet:
FT4232H #3 -> CH09..CH12. EEPROM serial: SBCU-3 (program with ftdi_eeprom).
TX is driven only while DTR# is asserted (port open). LVC Ioff => Hi-Z when unpowered.

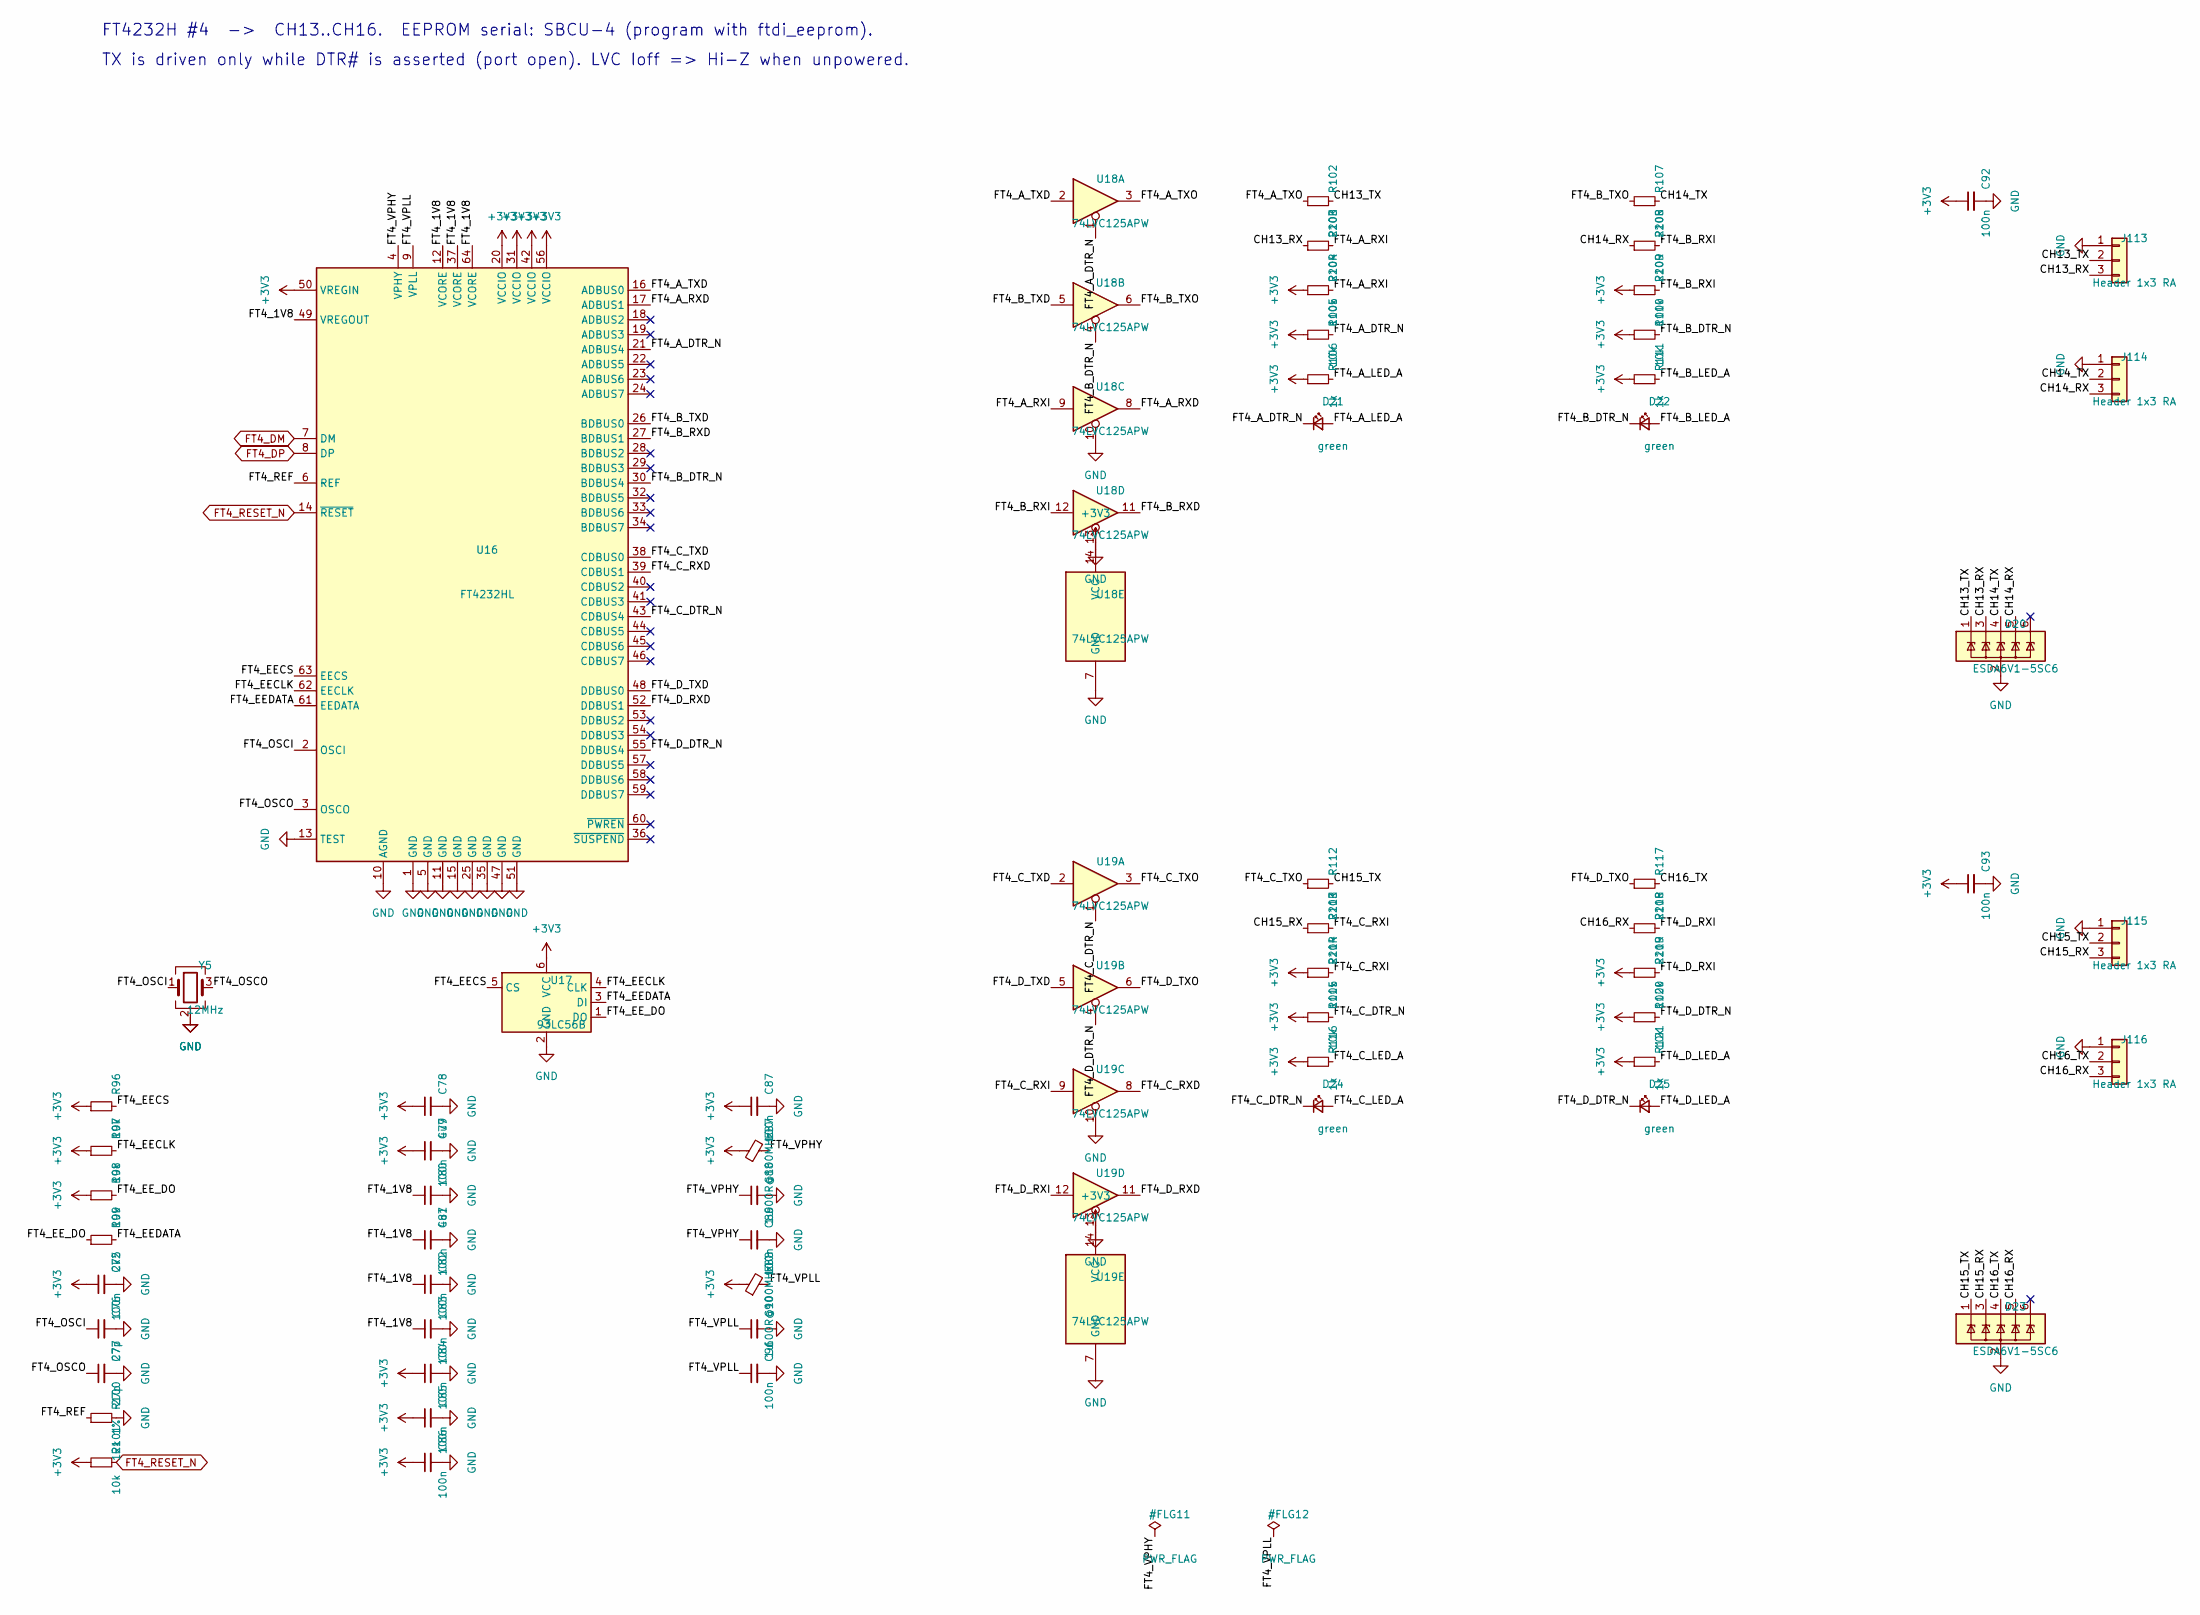
[picture p18: schematic ft4.kicad_sch, FT4232H #4: channels 13-16]

Parts:
C75, C79, C81, C82, C83, C84, C85, C86, C87, C89, C91, C92, C93: 100n; C_0402_1005Metric; MPN CL05B104KO5NNNC; LCSC C1525
C76, C77: 27p; C_0402_1005Metric; MPN 0402CG270J500NT; LCSC C1557
C78, C80: 4u7; C_0805_2012Metric; MPN CL21A475KAQNNNE; LCSC C1779
C88, C90: 1u; C_0402_1005Metric; MPN CL05A105KA5NQNC; LCSC C52923
D20, D23: ESDA6V1-5SC6; SOT-23-6; MPN ESDA6V1-5SC6; LCSC C2827672
D21, D22, D24, D25: green; LED_0603_1608Metric; MPN KT-0603G; LCSC C12624
FB7, FB8: 600R@100MHz; L_0603_1608Metric; MPN GZ1608D601TF; LCSC C1002
J113, J114, J115, J116: Header 1x3 RA; PinHeader_1x03_P2.54mm_Horizontal_Edge; MPN PZ254R-11-03P; LCSC C492411
R96, R97, R98, R101, R105, R110, R115, R120: 10k; R_0402_1005Metric; MPN 0402WGF1002TCE; LCSC C25744
R99: 2k2; R_0402_1005Metric; MPN 0402WGF2201TCE; LCSC C25879
R100: 12k 1%; R_0402_1005Metric; MPN 0402WGF1202TCE; LCSC C25752
R102, R103, R107, R108, R112, R113, R117, R118: 220R; R_0402_1005Metric; MPN 0402WGF2200TCE; LCSC C25091
R104, R109, R114, R119: 100k; R_0402_1005Metric; MPN 0402WGF1003TCE; LCSC C25741
R106, R111, R116, R121: 1k; R_0402_1005Metric; MPN 0402WGF1001TCE; LCSC C11702
U16: FT4232HL; LQFP-64_10x10mm_P0.5mm; MPN FT4232HL-REEL; LCSC C56742
U17: 93LC56B; SOT-23-6; MPN 93LC56BT-I/OT; LCSC C190271
U18, U19: 74LVC125APW; TSSOP-14_4.4x5mm_P0.65mm; MPN 74LVC125APW,118; LCSC C6059
Y5: 12MHz; Crystal_SMD_3225-4Pin_3.2x2.5mm; MPN X322512MSB4SI; LCSC C9002

Connections:
+3V3: C75.1, C78.1, C79.1, C84.1, C85.1, C86.1, C87.1, C92.1, C93.1, FB7.1, FB8.1, R96.1, R97.1, R98.1, R101.1, R104.1, R105.1, R106.1, R109.1, R110.1, R111.1, R114.1, R115.1, R116.1, R119.1, R120.1, R121.1, U16.20 (VCCIO), U16.31 (VCCIO), U16.42 (VCCIO), U16.50 (VREGIN), U16.56 (VCCIO), U17.6 (VCC), U18.14 (VCC), U19.14 (VCC); also elsewhere on the board
/FT4/CH13_RX: D20.3 (IO2), J113.3, R103.1
/FT4/CH13_TX: D20.1 (IO1), J113.2, R102.2
/FT4/CH14_RX: D20.5 (IO4), J114.3, R108.1
/FT4/CH14_TX: D20.4 (IO3), J114.2, R107.2
/FT4/CH15_RX: D23.3 (IO2), J115.3, R113.1
/FT4/CH15_TX: D23.1 (IO1), J115.2, R112.2
/FT4/CH16_RX: D23.5 (IO4), J116.3, R118.1
/FT4/CH16_TX: D23.4 (IO3), J116.2, R117.2
/FT4/FT4_1V8: C80.1, C81.1, C82.1, C83.1, U16.12 (VCORE), U16.37 (VCORE), U16.49 (VREGOUT), U16.64 (VCORE)
/FT4/FT4_A_DTR_N: D21.1 (K), R105.2, U16.21 (ADBUS4), U18.1
/FT4/FT4_A_LED_A: D21.2 (A), R106.2
/FT4/FT4_A_RXD: U16.17 (ADBUS1), U18.8
/FT4/FT4_A_RXI: R103.2, R104.2, U18.9
/FT4/FT4_A_TXD: U16.16 (ADBUS0), U18.2
/FT4/FT4_A_TXO: R102.1, U18.3
/FT4/FT4_B_DTR_N: D22.1 (K), R110.2, U16.30 (BDBUS4), U18.4
/FT4/FT4_B_LED_A: D22.2 (A), R111.2
/FT4/FT4_B_RXD: U16.27 (BDBUS1), U18.11
/FT4/FT4_B_RXI: R108.2, R109.2, U18.12
/FT4/FT4_B_TXD: U16.26 (BDBUS0), U18.5
/FT4/FT4_B_TXO: R107.1, U18.6
/FT4/FT4_C_DTR_N: D24.1 (K), R115.2, U16.43 (CDBUS4), U19.1
/FT4/FT4_C_LED_A: D24.2 (A), R116.2
/FT4/FT4_C_RXD: U16.39 (CDBUS1), U19.8
/FT4/FT4_C_RXI: R113.2, R114.2, U19.9
/FT4/FT4_C_TXD: U16.38 (CDBUS0), U19.2
/FT4/FT4_C_TXO: R112.1, U19.3
/FT4/FT4_D_DTR_N: D25.1 (K), R120.2, U16.55 (DDBUS4), U19.4
/FT4/FT4_D_LED_A: D25.2 (A), R121.2
/FT4/FT4_D_RXD: U16.52 (DDBUS1), U19.11
/FT4/FT4_D_RXI: R118.2, R119.2, U19.12
/FT4/FT4_D_TXD: U16.48 (DDBUS0), U19.5
/FT4/FT4_D_TXO: R117.1, U19.6
/FT4/FT4_EECLK: R97.2, U16.62 (EECLK), U17.4 (CLK)
/FT4/FT4_EECS: R96.2, U16.63 (EECS), U17.5 (CS)
/FT4/FT4_EEDATA: R99.2, U16.61 (EEDATA), U17.3 (DI)
/FT4/FT4_EE_DO: R98.2, R99.1, U17.1 (DO)
/FT4/FT4_OSCI: C76.1, U16.2 (OSCI), Y5.1
/FT4/FT4_OSCO: C77.1, U16.3 (OSCO), Y5.3
/FT4/FT4_REF: R100.1, U16.6 (REF)
/FT4/FT4_VPHY: C88.1, C89.1, FB7.2, U16.4 (VPHY)
/FT4/FT4_VPLL: C90.1, C91.1, FB8.2, U16.9 (VPLL)
FT4_DM: U16.7 (DM); also elsewhere on the board
FT4_DP: U16.8 (DP); also elsewhere on the board
FT4_RESET_N: R101.2, U16.14 (~RESET); also elsewhere on the board
GND: C75.2, C76.2, C77.2, C78.2, C79.2, C80.2, C81.2, C82.2, C83.2, C84.2, C85.2, C86.2, C87.2, C88.2, C89.2, C90.2, C91.2, C92.2, C93.2, D20.2 (GND), D23.2 (GND), J113.1, J114.1, J115.1, J116.1, R100.2, U16.1 (GND), U16.5 (GND), U16.10 (AGND), U16.11 (GND), U16.13 (TEST), U16.15 (GND), U16.25 (GND), U16.35 (GND), U16.47 (GND), U16.51 (GND), U17.2 (GND), U18.7 (GND), U18.10, U18.13, U19.7 (GND), U19.10, U19.13, Y5.2 (G), Y5.4 (G); also elsewhere on the board

Notes on the sheet:
FT4232H #4 -> CH13..CH16. EEPROM serial: SBCU-4 (program with ftdi_eeprom).
TX is driven only while DTR# is asserted (port open). LVC Ioff => Hi-Z when unpowered.

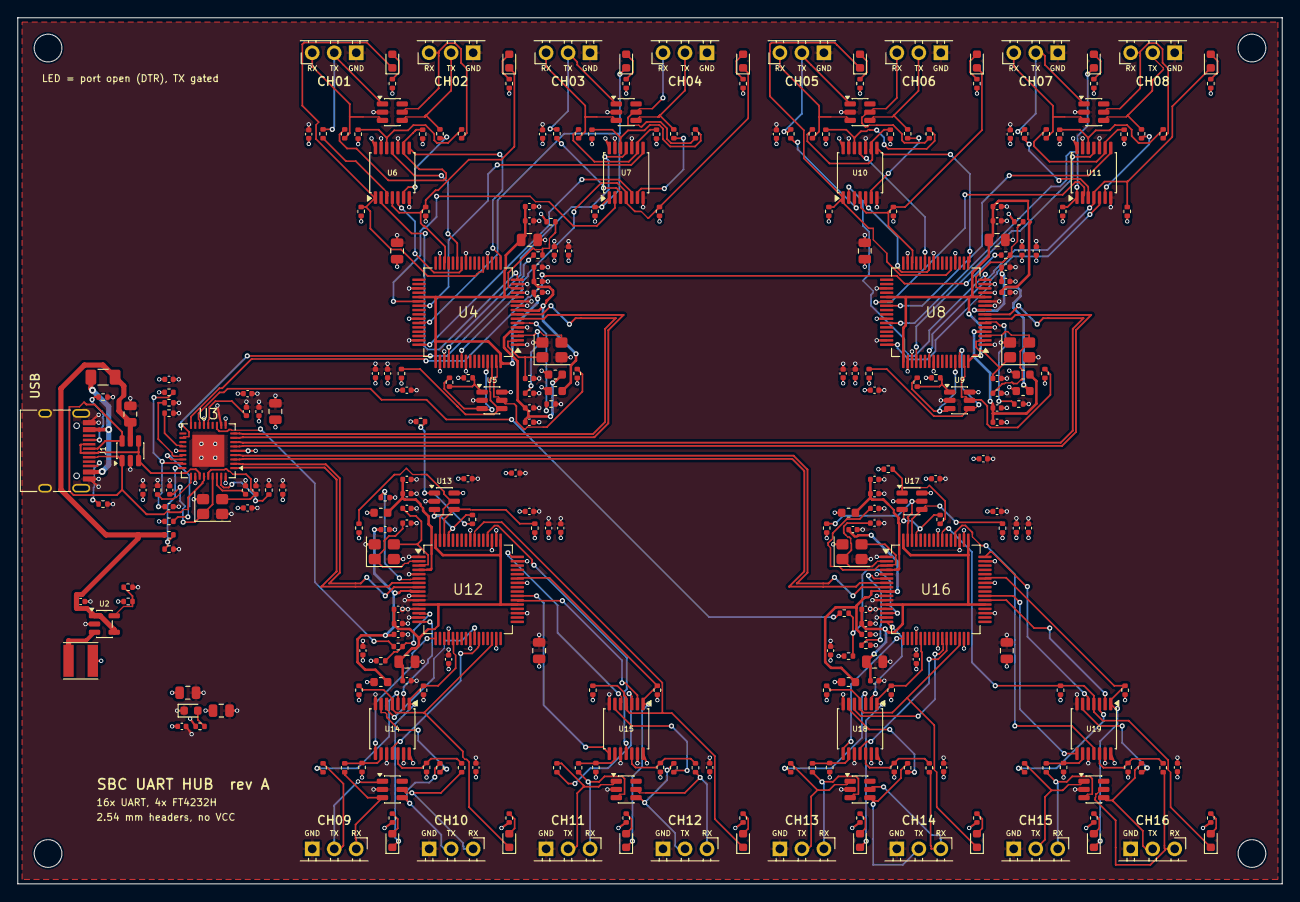
[picture p19: board sbc-uart-hub.kicad_pcb from above]

Board: 4 copper layers, 146.0 x 100.0 mm, 294 parts (0 on the bottom side), 206 nets.
