jernejsk/sbc-uart-hub/(commit log)

2026-11-08 Generated schematic: USB2514B + 4x FT4232H, 16 DTR-gated UART channels
    [ft1.kicad_sch, ft2.kicad_sch, ft3.kicad_sch, ft4.kicad_sch, hub.kicad_sch, power.kicad_sch, sbc-uart-hub.kicad_sch]
2026-11-08 PCB: placement, scripted USB pairs, fan-out, Freerouting, fab outputs, host files
    [bom_jlc.csv, ft1.kicad_sch, ft2.kicad_sch, ft3.kicad_sch, ft4.kicad_sch, hub.kicad_sch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]
2026-11-08 Switch DUT connectors to right-angle 2.54 mm headers, add datasheet
    Replace the 16 JST-XH sockets with right-angle 1x3 2.54 mm pin headers
    (LCSC C492411) so the DUT cables are stock female-female Dupont jumpers
    in any length. The plastic body sits flush with the board edge and the
    pins overhang it by 6 mm. A project footprint (gen/mkfp.py) drops the
    silkscreen that would lie past the edge.
    Header pins are numbered 1=RX 2=TX 3=GND, which puts every signal where
    it was on the XH layout, so the existing routing was kept:
    gen/rework_headers.py swaps the footprints, rips only the connector
    stubs, locks the rest and lets Freerouting finish. Silkscreen names
    each pin from its net.
    Also:
    - 3D mode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
    [bom_jlc.csv, ft1.kicad_sch, ft2.kicad_sch, ft3.kicad_sch, ft4.kicad_sch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]
2026-11-08 Measured JLC rotations, header pin 1 = GND, 24 MHz crystal fix, review
    CPL rotations are now measured per LCSC part instead of guessed by
    footprint family: gen/jlc_rot.py fits each KiCad footprint onto JLC's
    own EasyEDA footprint (pads by number, LEDs by cathode pin name, plus a
    body-side check) and writes gen/jlc_rot.json, which fab.py applies.
    The old rule-of-thumb table had the FT4232HL rotated 90 degrees, the
    ESD arrays and USBLC6 wrong, and the headers rotated 180 degrees with
    their pins pointing into the board.
    Headers: pin 1 is GND on the square pad. The project footprint numbers
    its pads mirrored against the stock one so every signal keeps its
    position and the routing is kept; two s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
    [bom_jlc.csv, ft1.kicad_sch, ft2.kicad_sch, ft3.kicad_sch, ft4.kicad_sch, hub.kicad_sch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]
